nvandegiesen/Intervalometer/Sensor1.jpg

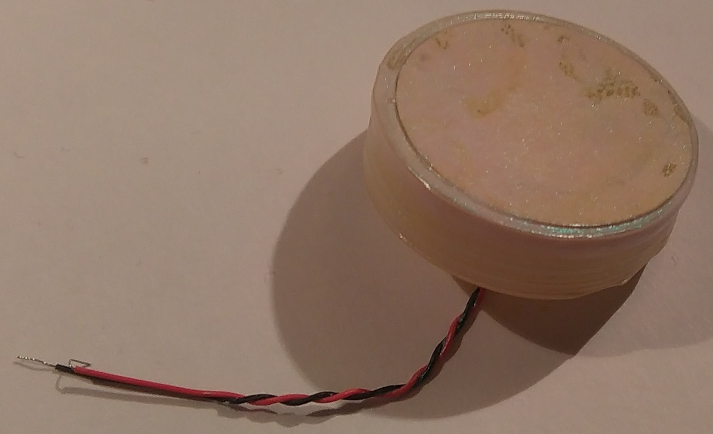
Sensor1.jpg
