nvandegiesen/Intervalometer/BACHELOR EINDPROJECT IRENE BACKERS.pdf

# Modelleren van Regenbuien in Afrika

# Modeling Rain Showers in Africa I.C.J. Backers

# Cover Text possibly spanning multiple lines ISBN 000-00-0000-000-0

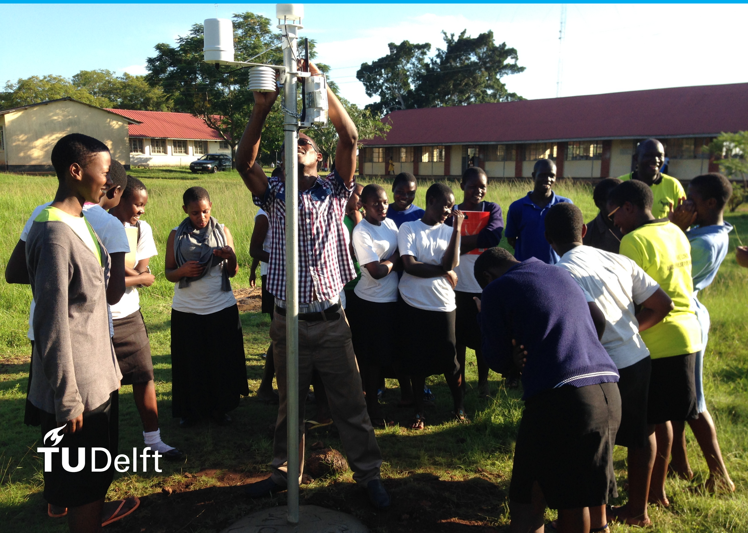
[picture p24: figure]

# Modelleren van Regenbuien in

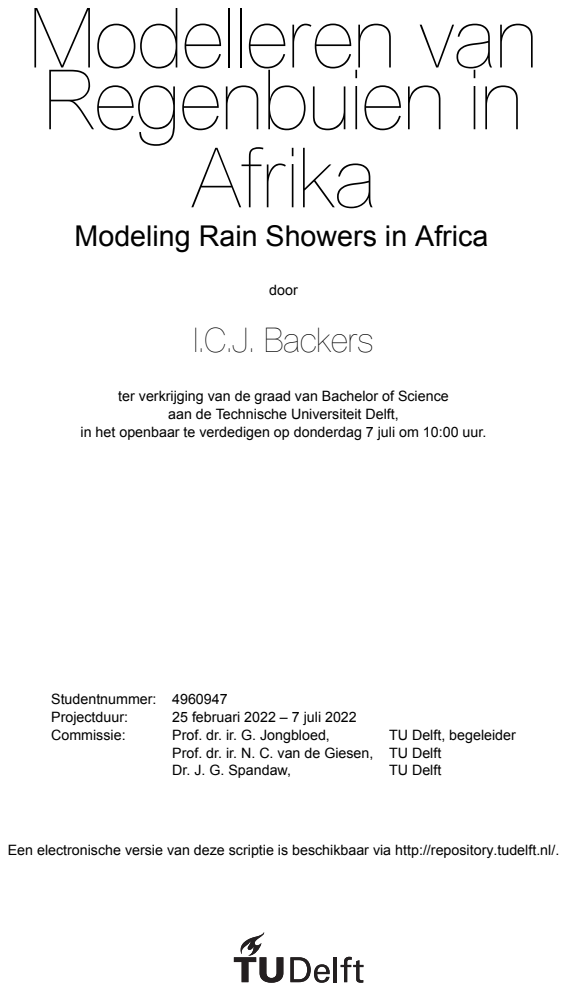
[picture p25: page 3]
Afrika; door I.C.J. Backers; Studentnummer: 4960947; Projectduur:; 25 februari 2022 – 7 juli 2022; Commissie:; Prof. dr. ir. G. Jongbloed,; TU Delft, begeleider; Dr. J. G. Spandaw,; TU Delft

Modeling Rain Showers in Africa

ter verkrijging van de graad van Bachelor of Science

aan de Technische Universiteit Delft,

in het openbaar te verdedigen op donderdag 7 juli om 10:00 uur.

Prof. dr. ir. N. C. van de Giesen, TU Delft

Een electronische versie van deze scriptie is beschikbaar via http://repository.tudelft.nl/.

# Voorwoord

Door klimaatveranderingen lijkt het weer steeds extremer te worden en moeilijker te voorspellen. Voor Afrika is erg weinig data beschikbaar om klimaatverandering te meten of in weermodellen te gebruiken. Vanuit de TU Delft is daarom al vanaf 2007 gewerkt aan de opzet van een netwerk van lowcost weerstations om gronddata te verzamelen.
Initator van dit project en voorzitter van Delft Global Initiative Prof. dr. ir. Nick van de Giesen klopte aan bij de afdeling statistiek van wiskunde met de vraag dat hij graag een metriek wilde hebben die de mate van Poissoniteit van de regen kwantificeert.

Door zelf opzoek te gaan naar een onderwerp voor mijn BEP ben ik met een paar mailtjes bij dit project terecht gekomen waar ik met veel plezier aan heb gewerkt. Wat voor mij het project zo leuk maakte, was dat ik kon werken met echte data. Alle rekenkunsten die ik de afgelopen vier jaar heb geleerd kon ik nu eindelijk echt een keer toepassen om een probleem waarvan het antwoord niet al van te voren vast staat. En wat het helemaal bijzonder maakt is dat het een heel klein deelprojectje is van een veel groter project om het klimaat van Afrika beter in kaart te brengen.
Graag wil ik Prof. dr. ir. Geurt Jongbloed heel erg bedanken voor de wekelijkse bijeenkomsten met nuttige gesprekken, suggesties, hulp en tijd. Ook Prof. dr. ir. Nick van de Giesen wil ik bedanken voor de hulp bij het formuleren van dit project, het beschikbaar stellen van de gebruikte data en voor het periodiek aanschuiven bij de bijeenkomsten. Als laatste wil ik ook Dr. Jeroen Spandaw bedanken voor het completeren van mijn beoordelingscommissie.

Irene Backers
Delft, Juni 2022

iii

# Samenvatting

Om goed te kunnen voorspellen waar, wanneer en hoeveel het gaat regenen is het belangrijk om satellietbeelden, weermodellen en grondmetingen te combineren. Het in 2007 opgezette project ‘The Trans-African Hydro-Meteorological Obsevatory’ (TAHMO) heeft de afgelopen jaren 500 goedkope weerstations geplaatst, verspreid over 21 landen in Sub-Sahara Afrika en wil uitbreiden naar 20.000 weerstations. De grondmetingen die met de al geplaatste weerstations zijn gedaan, kunnen gebruikt worden om weermodellen te ontwikkelen en te verbeteren.

Over de te verwachten regenval in Afrika is nog weinig bekend. Vaak wordt regen gemodelleerd met een Poissonproces. Daarom is vanuit ‘Delft Global Initiative’ de vraag gekomen of het Poissonproces een goed model kan zijn voor regenval in Afrika.

In dit onderzoek hebben we regendata van één weerstation gebruikt dat tijdens de moesson gegevens heeft verzameld op Mafia eiland, een eiland zo’n 20 kilometer voor de kust van Tanzania.

Een Poissonproces kan homogeen of inhomogeen zijn en we hebben de data op beide processen getoetst. Voor het homogene Poissonproces zijn veel verschillende toetsen te vinden in de literatuur. De Monte Carlo simulaties zijn gebaseerd is op de geïntegreerde verdelingsfunctie en gebruikt om de p-waarde te bepalen. Voor alle regen samen in de gehele observatieperiode was de p-waarde 0 en daarom kan de regen niet met een homogeen Poissonproces worden beschreven.
Voor de inhomogeen Poissonproces benadering hebben we ervoor gekozen om de intensiteit van de regen te benaderen met een stuksgewijs constante intensiteit. Met taut string werd de regen opgedeeld in 474 deelperiodes met een constante intensiteit die per deelperiode verschilt. Voor iedere deelperiode werd getoetst of de regen met een homogeen Poissonproces kan worden beschreven. De p-waarde werd voor iedere deelperiode bepaald met Monte Carlo simulaties en werken met een significantieniveau van 5%. Voor 448 van de 474 deelperiodes kan de regen met een homogeen Poissonproces worden beschreven.

Een inhomogeen Poissonproces met stuksgewijs constante intensiteit lijkt daarom een redelijk bruikbaar model om de regen op Mafia eiland mee te beschrijven. Of dit model ook bruikbaar is voor alle andere weerstations van TAHMO zullen toekomstige studies moeten uitwijzen.

v

# Lekensamenvatting

Om goed te kunnen voorspellen waar, wanneer en hoeveel het gaat regenen is het belangrijk om satellietbeelden, weermodellen en grondmetingen te combineren. Het in 2007 opgezette project ‘The Trans-African Hydro-Meteorological Obsevatory’ (TAHMO) heeft de afgelopen jaren 500 goedkope weerstations geplaatst, verspreid over 21 landen in Sub-Sahara Afrika en wil uitbreiden naar 20.000 weerstations. Over het voorspellen van regen in Afrika is nog nauwelijks wat bekend.

In dit onderzoek hebben we regendata van één weerstation gebruikt dat tijdens de moesson gegevens heeft verzameld op Mafia eiland, een eiland zo’n 20 kilometer voor de kust van Tanzania. Het Poissonproces is een gebruikelijk model om regen te modelleren. Uit de analyse van de data blijkt dat dit Poissonproces hier geen goed model is om de regen te beschrijven. Wanneer de regenmeting in kleinere deelperiodes wordt opgedeeld blijkt dat het Poissonproces de regen voor 448 van de 474 deelperiodes wel goed kan beschrijven en bruikbaar is om de regen op Mafia eiland mee te beschrijven. Of dit model, dat een inhomogeen Poissonproces wordt genoemd, ook bruikbaar is voor alle andere weerstations van TAHMO zullen toekomstige studies moeten uitwijzen.

vii

# Inhoudsopgave

Samenvatting | v
Lekensamenvatting | vii
1 Inleiding | 1
2 Het hoe, wat, waar en waarom van de dataverzameling | 3
3 Het Poissonproces | 9
4 Toetsen voor een homogeen Poissonproces | 15
5 Toetsen voor een inhomogeen Poissonproces | 35

5.2.3 Stap 3: Trek uit Poissonverdelingen met parameters uit de begin-intensiteit 40
5.2.4 Stap 4: Bepaal penalty parameter zodat afstand begin-intensiteit en ge-

ix

x | Inhoudsopgave
6 Conclusie en Discussie | 53

1

# Inleiding

Afrika’s economie is voor een groot deel afhankelijk van regen en toch weten we nog maar heel weinig over waar, wanneer en hoeveel het regent in Afrika. Met alle wetenschappelijke kennis van nu is dit onaanvaardbaar (TUDelft, 2019), zeker als je bedenkt dat de grootste sector in Afrika de agrarische sector is en dat de verbouwing van 98% van de gewassen afhankelijk is van regenwater (de Villiers e.a., 2021).

Om goed te kunnen voorspellen waar, wanneer en hoeveel het gaat regenen, moeten satellietbeelden, weer/klimaatmodellen en grondmetingen gecombineerd worden. Het ontbrak hierbij vooral aan de grondmetingen. Daarom is in 2007 ‘The Trans-African Hydro-Meteorological Observatory’ (TAHMO) opgezet. Het doel is om 20.000 goedkope weerstations te plaatsen verspreid over heel Sub-Sahara Afrika en zo het weer, het klimaat en de regen beter in beeld te kunnen brengen (TUDelft, 2019). De opstartfase duurde lang waardoor er pas in 2015 echt begonnen kon worden en er in juli 2019 500 weerstations verspreidt over 21 landen stonden.

Als we de regen beter kunnen voorspellen kan de voedselproductie verbeteren met alle voordelen van dien. Door de weerstations bij scholen te plaatsten en het op te nemen in het schoolprogramma, heeft het project ook educatieve waarde.

De data die met de grondmetingen verzameld is, kan gebruikt worden bij het verbeteren en ontwikkelen van weermodellen. Vaak wordt regen gemodelleerd met een Poissonproces en vanuit Delft Global Initiative (DelftGlobal, 2022) is de vraag gekomen of het Poissonproces een goed model kan zijn voor regenval in Afrika.

Uit een master thesis geschreven in 2019 en het daarop volgende artikel van de Villiers e.a., 2021 blijkt dat dit model voor de regen in Afrika niet goed past. In het artikel wordt het vermoeden geformuleerd dat regen met een lage intensiteit, bijvoorbeeld miezer, wel gemodelleerd kan worden met een Poissonproces, maar dat voor regen met hoge intensiteit, bijvoorbeeld een stortbui, het Poissonproces geen goed model lijkt te zijn.
In het artikel wordt met ‘Poisson’ verwezen naar een homogeen Poissonproces. De lichte regen lijkt dus wel een homogeen Poissonproces te zijn, maar de zwaardere regen niet. In het artikel wordt ook gewezen op het feit dat je een inhomogeen Poissonproces zou kunnen splitsen in kleinere stukken die homogeen Poisson zijn.

1

2 | 1. Inleiding

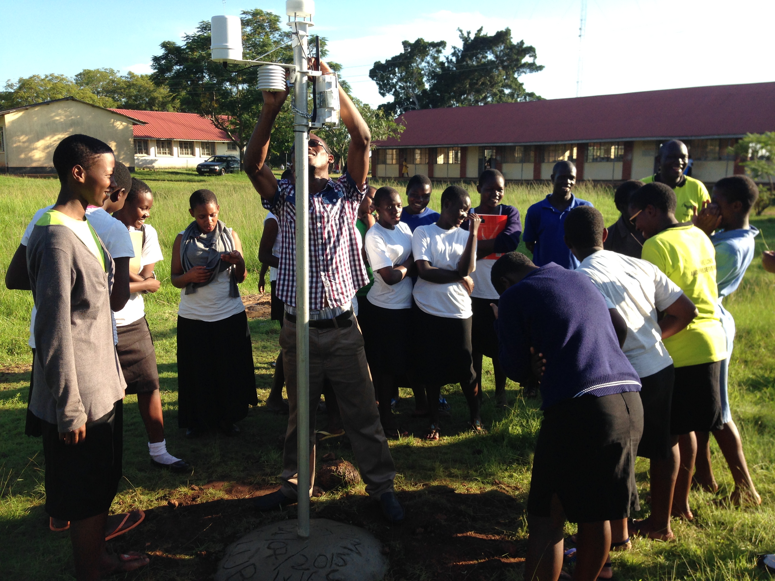
[picture p26: figure]

Figuur 1.1: Een weerstation bij een school in Afrika. Overgenomen van TUDelft, 2019

Het doel van dit project is om te onderzoeken of een Poissonproces, homogeen of inhomogeen, een redelijk model is om de regenbuien in Afrika mee te modelleren. Belangrijk om hierbij te onthouden is de wijsheid van de Britse statisticus George Box:

“All models are wrong, but some are useful”

Om het antwoord te vinden op deze vraag toetsen we eerst of de regen door een homogeen Poissonproces kan worden beschreven. Hiervoor gebruiken we een toets uit de literatuur. Daarna zullen we de regen toetsen op een inhomogeen Poissonproces door de data te benaderen met een stuksgewijs homogeen Poissonproces. We delen de regen op in allemaal kleine homogene Poissonprocessen die samen een inhomogeen Poissonproces vormen.

De structuur van het verslag is als volgt. Als eerste wordt in hoofdstuk 2 de data uitgelegd. Er wordt onder andere ingegaan op de gebruikte meetapparatuur, waar in Afrika de data voor dit project verzameld is, wanneer en waarom de data verzameld is en als laatste wordt uitgelegd hoe de beschikbare data eruit ziet. In hoofdstuk 3 wordt uitgelegd wat een Poissonproces is en hoe de data gebruikt kan worden om te toetsen op een homogeen of inhomogeen Poissonproces. Hoofdstuk 4 geeft een overzicht van (een deel van) de vele toetsen die er in de literatuur zijn voor een homogeen Poissonproces. Vervolgens wordt één van deze toetsen gekozen en uitgevoerd op de regendata. Tot slot wordt in hoofdstuk 5 de regendata getoetst op een inhomogeen Poissonproces. Hiervoor wordt eerst de intensiteit van de regen geschat met Taut String. Dit geeft een stuksgewijs constante intensiteit waardoor de regendata verdeeld wordt in periodes met dezelfde intensiteit. Deze periodes worden vervolgens getoetst op een homogeen Poissonproces.

2

# Het hoe, wat, waar en waarom van de dataverzameling

Dit hoofdstuk geeft een overzicht van de dataverzameling. Als eerste kijken we in paragraaf 2.1 naar de meetapparatuur waarmee de data verzameld is. In paragraaf 2.2 wordt uitgelegd waar en waneer de data verzameld is. Paragraaf 2.3 legt uit waarom de data verzameld is. Als laatste staat in paragraaf 2.4 welk deel van de beschikbare data gebruikt is voor dit project en wordt uitgelegd hoe de beschikbare data eruit ziet.

## 2.1. De meetapparatuur

De data is verzameld met drie verschillende meetinstrumenten: tipping bucket regenmeters gemaakt door Onset in de Verenigde Staten, akoestische disdrometers gemaakt door Disdro in Delft en intervalometers. In figuur 2.1 staat van alle drie een foto.
Tipping buckets meten de hoeveelheid regen, disdrometers registreren de aankomst van regendruppels en berekenen de grootte van de druppels en intervalometers registreren de aankomst van regendruppels (de Villiers, 2019). Voor dit onderzoek is gebruikt gemaakt van metingen gedaan met een intervalometer.

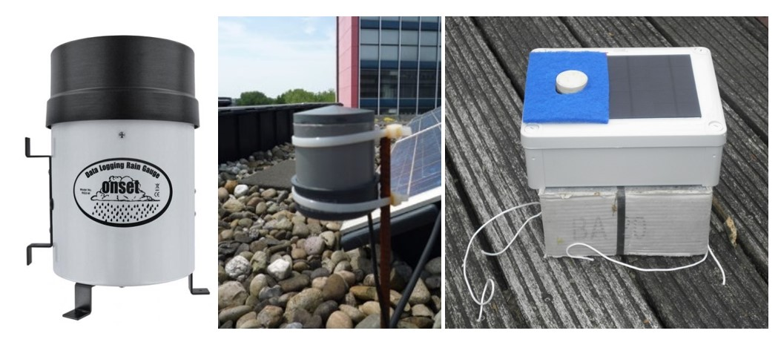
[picture p27: figure]

Figuur 2.1: De gebruikte meetinstrumenten. Van links naar rechts: een tipping bucket, een akoestische disdrometer en een intervalometer. Overgenomen van ONSET, 2022, Nieuwenhuizen, 2010 en van de Giesen, 2019.

3

4 | 2. Het hoe, wat, waar en waarom van de dataverzameling
| Intervalometers zijn meetinstrumenten die goedkoop zijn in aanschaf, gebruik en onder-
houd (TUDelft, 2022a). Ze kosten rond de 200 dollar, terwijl soortgelijke meetinstrumenten voor de Europese markt pas verkrijgbaar zijn vanaf 2000 dollar en meer (TUDelft, 2010). Het maken van dit goedkope meetinstrument kan door al bestaande apparatuur of onderdelen hiervan te gebruiken voor een ander doel dan waar het oorspronkelijk voor ontworpen was (TUDelft, 2010). Zo maakt een intervalometer gebruik van een piëzo-elektrische sensor van ongeveer 3,5 cm groot zoals in figuur 2.2. Als er een druppel op de sensor valt, dan vervormt de sensor en wordt er spanning opgewekt. Door de sensor aan een computer te verbinden, kan geregistreerd worden wanneer de druppels gevallen zijn en bijvoorbeeld ook hoe groot de druppels waren (van de Giesen, 2019).

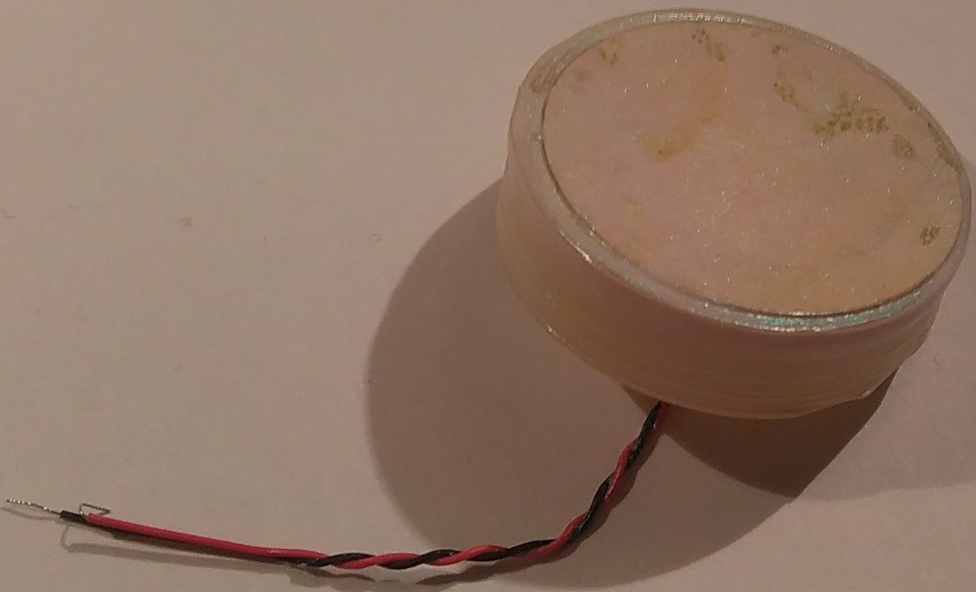
[picture p28: figure]

Figuur 2.2: De Piëzo-elektrische sensor die gebruikt wordt voor een intervalometer. De sensor is zo’n 3,5 cm groot en wekt spanning op als er een druppel op valt. Overgenomen van van de Giesen, 2019.

## 2.2. Waar en wanneer is de data verzameld?

De data is verzameld op acht locaties langs de zuidkust van Mafia Eiland, een eiland dat ongeveer 20 kilometer voor de kust van Tanzania. De locaties liggen in een gebied van 3,1 km bij 500 m en ongeveer in een lijn zoals de kaart in figuur 2.3 laat zien (de Villiers e.a., 2021). Op elke locatie staat in ieder geval één intervalometer. Pole Pole heeft naast een intervalometer ook nog een disdrometer en een tipping bucket; MIL 1 heeft twee intervalometers en een tipping bucket (de Villiers, 2019). De meetinstrumenten zijn zo geplaatst dat ze qua toegankelijkheid en landschap zo goed mogelijk voldoen aan de eisen van de Wereld Meteorologische Organisatie (de Villiers e.a., 2021), dit is een gespecialiseerde organisatie van de Verenigde Naties op het gebied van weer, klimaat en water (“Our Mandate”, 2022).

2.2. Waar en wanneer is de data verzameld? | 5

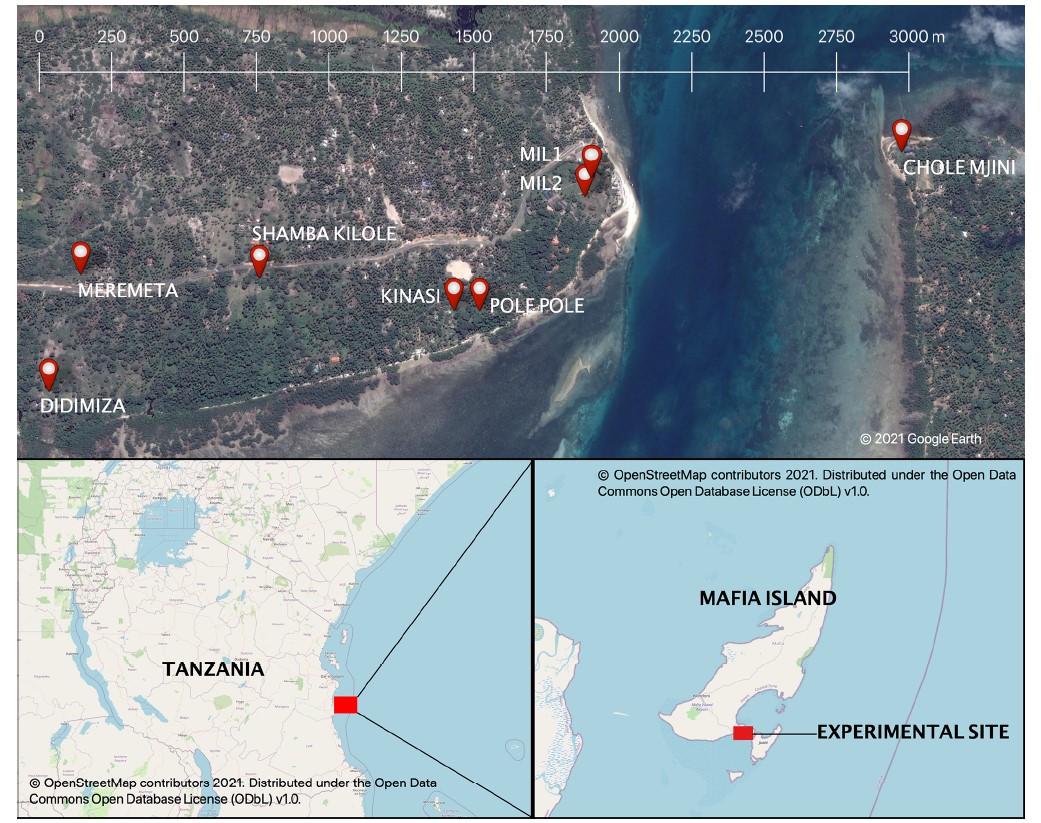
[picture p29: figure]

Figuur 2.3: De acht locaties waar de data verzameld is. Op alle locaties staat een intervalometer. Pole Pole heeft naast de intervalometer nog een disrometer en een tipping bucket. MIL 1 heeft nog een extra intervalometer (twee in totaal) en een tipping bucket. Overgenomen van de Villiers e.a., 2021.

De data is verzameld tijdens de moesson in Afrika. De eerste meting is gedaan op 27 april 2018 en de laatste op 18 juni 2018. Helaas is de dataverzameling niet altijd goed gegaan. Zo heeft de disdrometer vanaf 20 mei een oscillerend signaal gemeten waardoor de data niet meer te gebruiken is. Ook hebben een aantal intervalometers waterschade opgelopen tijdens zware buien waardoor ze tijdelijk geen data konden verzamelen. Twee intervalometers zijn dusdanig beschadigd dat ze niet meer te repareren waren.

Figuur 2.4 laat zien welke intervalometer wanneer data heeft verzameld. Elke intervalometer heeft de naam van de locatie behalve MIL 3, dit is de tweede intervalometer die bij MIL 1 staat.

Waarschijnlijk heeft het de ochtend van 9 mei hard geregend. Alle intervalometers die het op dat moment deden, zijn namelijk 9 mei uitgevallen, de eerste om 05:02 uur, de laatste om 09:13 uur. Op 12 mei waren de meeste intervalometers weer gerepareerd, alleen Chole Mjini en Shamba Kilole niet.

Na 12 mei zijn veel intervalometers nog één of meerdere keren uitgevallen. Daarom wordt er gewerkt aan een robuustere versie van de intervalometer

6 | 2. Het hoe, wat, waar en waarom van de dataverzameling

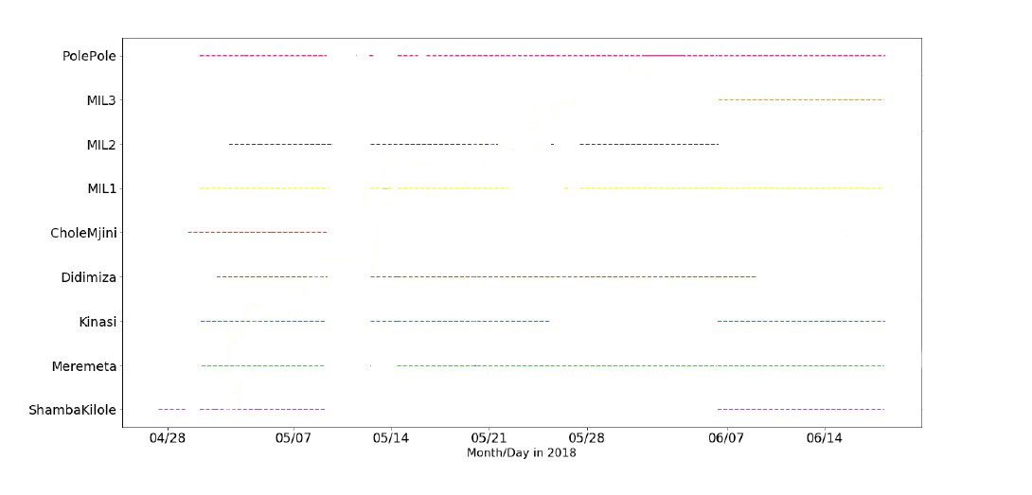
[picture p30: figure]

Figuur 2.4: Voor iedere locatie de periodes dat de intervalometers data hebben verzameld. Iedere intervalometer heeft de naam van de locatie behalve MIL 3, dit is de tweede intervalometer die bij MIL 1 staat. Aangepast overgenomen van de Villiers e.a., 2021.

## 2.3. Waarom wordt de data verzameld?

Momenteel weten we een stuk minder over het weer en klimaat in Afrika dan in bijvoorbeeld Europa (TUDelft, 2010). Dat we zo weinig weten van het weer en klimaat in Afrika komt onder andere door een gebrek aan data. Satellietbeelden waren er al wel maar data waargenomen vanaf de grond was er nauwelijks. In 2015 stond er volgens de Villiers e.a., 2021 minder dan één weerstation per 1 miljoen vierkante kilometer.
Ter vergelijking: in Nederland staan 48 automatische weerstations waarvan er 34 op land staan en 14 op zee (KNMI, 2022). Dit is één automatisch weerstation per 1.222 km²
. Naast
deze automatische weerstations staan er verspreid over heel Nederland ook nog ruim 300 neerslagmeters van vrijwilligers (KNMI, 2022).

Met de beschikbare satellietbeelden in Afrika kunnen wel wolken worden waargenomen, maar je weet dan nog niet of het regent, waar het regent en hoeveel het regent. Om dat te kunnen weten, heb je grondwaarnemingen nodig en zo ontstond het idee om ‘The Trans-African Hydro-Meteorological Observatory’ (TAHMO) op te zetten. Het doel is om 20.000 goedkope weerstations te plaatsten verspreid over Sub-Sahara Afrika (TUDelft, 2019). Deze grondwaarnemingen kunnen gebruikt worden om betere weer- en klimaatmodellen te ontwikkelen. Vervolgens kunnen de grondwaarnemingen, de modellen en de satellietbeelden gecombineerd worden om een goed beeld te krijgen van waar, wanneer en hoeveel het regent.

Het beter kunnen voorspellen van de regen heeft meerdere voordelen (TUDelft, 2022b). Op wetenschappelijk gebied krijgen we meer inzicht in het hydrologisch systeem. Deze kennis kan gebruikt worden op het gebied van waterkracht, irrigatie, drinkwater en overstromingen. Financieel gezien kunnen regeringen beter beslissen waarin geïnvesteerd gaat worden op het gebied van watermanagement. Door in de juiste dingen te investeren, kan er beter geanticipeerd worden op het weer waardoor oogsten kunnen verbeteren. De voedselproductie kan dus toenemen maar ook de oogstvoorspellingen worden beter. Ook kan de data gebruikt worden door verzekeraars, zo kunnen boeren bijvoorbeeld eerlijker gecompenseerd worden als er oogsten mislukken.

2.4. Welke data is er gebruikt en hoe ziet die data er uit? | 7

Als laatste zullen er ook educatieve voordelen zijn. De meetinstrumenten worden bij scholen geplaatst en worden opgenomen in het onderwijs. Zo kunnen de kinderen leren over het klimaat in Afrika en hun verbondenheid daarmee. Bij natuurkunde kunnen de meetinstrumenten worden gebruikt om experimenten te doen en het kan gebruikt worden om wiskunde toe te passen.

## 2.4. Welke data is er gebruikt en hoe ziet die data er uit?

Er is bijna 3 maanden aan regendata beschikbaar van acht verschillende locaties. Op aanraden van Didier heb ik er voor gekozen om data te gebruiken van een regenbui opgenomen op Pole Pole. Het gaat om regen die gevallen is vanaf 1 mei 12 uur tot 3 mei 10:30 uur. Deze periode noemen we de observatieperiode. In figuur 2.4 komt dit overeen met het eerste stukje van de roze stippellijn helemaal linksboven in de figuur.
De intervalometer heeft de tijdstippen opgenomen wanneer er een druppel op de drum valt. Van iedere druppel weten we tot op de milliseconde wanneer deze gevallen is. Ook hebben we een bestand met het aantal gevallen regendruppels per interval van 10 seconden. Een weergave hiervan staat in figuur 2.5. Op de x-as staat de tijd in uren waarbij we 1 mei 12 uur gelijk gesteld hebben aan tijdstip 0; op de y-as staat het aantal regendruppels per interval van 10 seconden. Het aantal druppels per interval heeft te maken met de intensiteit van de regen. Regent het zacht, dan zullen er weinig druppels per interval zijn. Regent het hard, dan zullen er veel druppels per interval zijn. De eerste 20 uur zijn er alleen maar intervallen met 0, 1, 2 of 3 druppels. Het heeft toen dus niet hard geregend. De drie uur daarna vielen er meer druppels per interval en heeft het dus harder geregend.

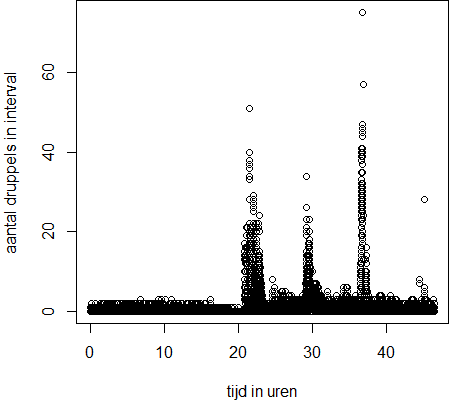
[picture p31: figure]

Figuur 2.5: Een weergave van het aantal druppels per interval gevallen bij Pole Pole van 1 mei 12 uur tot 3 mei 10:30. Op de x-as de tijd in uren met 1 mei 12 uur als tijdstip 0, op de y-as staat het aantal druppels per interval.

3

# Het Poissonproces

Dit hoofdstuk zal worden uitgelegd wat een Poissonproces is en hoe dit in de data terug kan komen. In paragraaf 3.1 worden definities en eigenschappen van een Poissonproces gegeven en uitgelegd. Vervolgens worden er drie manieren uitgelegd om naar een Poissonproces te kijken in paragraaf 3.2. Als laatste wordt in paragraaf 3.3 gekeken hoe de data zich moet gedragen als het een Poissonproces volgt en wordt er gekeken naar de mogelijkheden en onmogelijkheden van de data voor het toetsen op een homogeen en inhomogeen Poissonproces.

## 3.1. Wat is een Poissonproces?

Een Poissonproces is een speciaal soort telproces en telt of registreert het aantal ‘gebeurtenissen’ in een bepaald tijdsinterval (Pishro-Nik, 2014). Zo’n gebeurtenis wordt een aankomst genoemd. De aankomsten van een Poissonproces gebeuren met een bepaalde intensiteit maar wel volledig willekeurig zonder enige structuur en onafhankelijk van elkaar (Pishro-Nik, 2014). De intensiteit van het proces is het aantal aankomsten dat je verwacht in een tijdsinterval van lengte 1. Een Poissonproces wordt onder andere gebruikt voor het modelleren van de aankomst van mensen in een winkel, de uitstoot van radioactieve deeltjes door radioactief afval en het overgaan van de telefoon bij een klantenservice (Grimmett en Welsh, 2014).

Je kan het aantal aankomsten in een tijdsinterval registeren. Laat de tijd lopen van 0 tot oneindig, dus t ∈ [0, ∞), en laat Nt het aantal aankomsten tot en met tijdstip t zijn, dus in het interval [0, t]. Het proces N = (Nt

∶ t ∈ [0, ∞)) begint op tijdstip t = 0 met nul aankomsten N0 = 0, bij elke volgende aankomst neemt de waarde van het proces met 1 toe. Dit betekent dat het proces waardes aanneemt in {0,1,2,3,...} en dat N een discreet stochastisch proces is in continue tijd (Grimmett en Welsh, 2014). N = (Nt

∶ t ∈ [0, ∞)) is een telproces als het voldoet aan de volgende voorwaarden (Pishro-Nik, 2014, Grimmett en Welsh, 2014):

1. Nt

is een stochastische variabele die waardes aan neemt in {0, 1, 2, … },

2. N0 = 0, op tijdstip nul zijn er nul aankomsten,
3. Ns ≤ Nt als s ≤ t, het is dus een stijgend proces,
4. Voor 0 ≤ s < t is Nt − Ns het aantal aankomsten in het interval (s, t]. Dit aantal is onafhankelijk van het aantal aankomst voorafgaand aan s dus in het interval [0, s)

Een telproces heeft onafhankelijke aangroeiingen als voor 0 ≤ t1 < t2 < ⋯ < tn de stochastische variabelen Nt2−Nt1

, Nt3−Nt2

, …, Ntn−Ntn−1 onafhankelijk zijn van elkaar. Merk op

9

10 | 3. Het Poissonproces

dat Nti −Nti−1 het aantal aankomsten zijn in het tijdsinterval (ti−1, ti

]. Daarom heeft een telproces onafhankelijk aangroeiingen als de aantalen aankomsten in disjuncte (niet-overlappende) intervallen onafhankelijk zijn van elkaar (Pishro-Nik, 2014).

Een speciaal soort telproces is het Poissonproces. Er zijn meerdere manieren om een Poissonproces te definiëren waarvan één via de Poissonverdeling.
N = (Nt

∶ t ∈ [0, ∞)) is een Poissonproces met intensiteit λ als N voldoet aan de vier bovenstaande eisen van een telproces én als het aantal aankomsten tot en met tijdstip t een Poissonverdeling heeft met parameter λt. λ is het verwachte aantal aankomsten per interval van lengte 1. Dat betekent dat voor t > 0 de kans op j aankomsten in het tijdsinterval [0, t] gegeven is door (Grimmett en Welsh, 2014)

ℙ(Nt = j) =

(λt)je

−λt
j! | voor j = 0, 1, 2, … .

Uit deze definitie van een Poissonproces volgt dat de verwachting en de variantie van het aantal aankomsten tot en met tijdstip t, Nt

, gelijk is aan elkaar en lineair toeneemt als t toeneemt, namelijk:

E [Nt
] = λt, | var (Nt
) = λt | voor t > 0.

De intensiteit λ bepaalt of het Poissonproces homogeen of inhomogeen is. Als λ constant is in de tijd, dan is het Poissonproces homogeen. Als λ varieert in de tijd, dan is het Poissonproces inhomogeen.

Een homogeen Poissonproces heeft een aantal mooie eigenschappen waaronder het samenvoegen en splitsen van Poissonprocessen.
Neem aan dat N1 een Poissonproces is met intensiteit λ1 en dat N2 een Poissonproces is met intensiteit λ2 onafhankelijk van N1. Het samengevoegde proces N = N1 + N2 is dan een Poissonproces met intensiteit λ1 + λ2 (Grimmett en Welsh, 2014). Dit is gevisualiseerd in figuur 3.1.

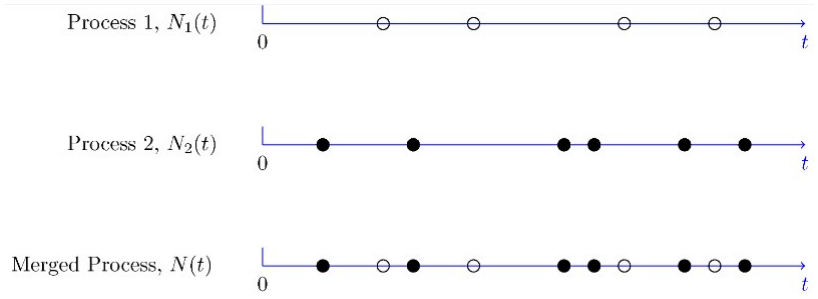
[picture p32: figure]

Figuur 3.1: Het samenvoegen van twee onafhankelijke Poissonprocessen. Overgenomen van Pishro-Nik, 2014.

Een Poissonproces kan ook gesplitst worden. Laat N een Poissonproces zijn met intensiteit λ, het proces kan op de volgende manier gesplitst worden in twee processen N1 en N2. Elke aankomst van het Poissonproces N gaat met kans p naar proces N1 en met kans 1 − p naar proces N2. N1 en N2 zijn dan onafhankelijk Poissonprocessen met intensiteit λp voor N1 en λ (1 − p) voor N2. Dit is gevisualiseerd in figuur 3.2.

3.2. Drie mogelijkheden om naar een Poissonproces te kijken | 11

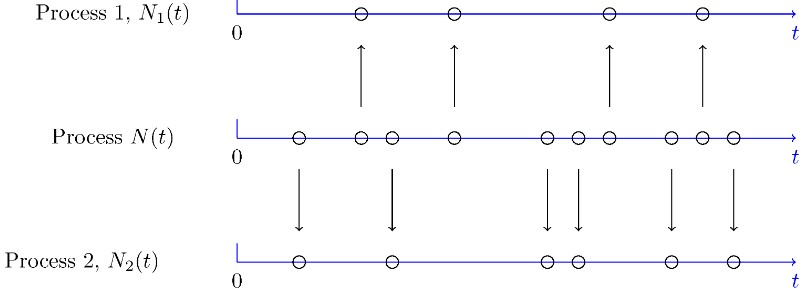
[picture p33: figure]

Figuur 3.2: Het splitsen van een Poissonproces in twee onafhankelijke Poissonprocessen. Overgenomen van Pishro-Nik, 2014.

Een andere eigenschap en ook definitie van een homogeen Poissonproces heeft te maken met de tussenaankomsttijden. De tussenaankomsttijd is de tijd tussen twee opeenvolgende aankomsten. Voor een homogeen Poissonproces met intensiteit λ zijn de tussenaankomsttijden onafhankelijke stochastische variabelen met de exponentiële verdeling met parameter λ.
Volgens Grimmett en Welsh, 2014 is dit niet alleen een eigenschap van een Poissonproces maar ook een manier om het Poissonproces te definiëren. Namelijk: als de tussenaankomsttijden van een proces onafhankelijk en exponentieel verdeeld zijn met parameter λ, dan is het een Poissonproces met intensiteit λ.

Een kenmerk van de exponentiële verdeling is de geheugenloosheid. Wat er in het verleden gebeurd is, heeft vanwege de geheugenloosheid geen invloed op wat op dit moment gaat gebeuren. Voor een Poissonproces betekent de geheugenloosheid dat de tijd van de eerdere aankomsten geen invloed heeft op de tijd van de volgende aankomst (Grimmett en Welsh, 2014).
Laat Ti de tussenaankomsttijd zijn van aankomsten i en i − 1, dus de tijd tussen aankomst i en aankomst i − 1. Gegeven dat we al tijd s wachten op de volgende aankomst, dan is de kans om nog tijd t extra te moeten wachten net zo groot als dat we vanaf het begin tijd t moeten wachten. Wiskundig is dit als volgt in kansen uit te drukken (Grimmett en Welsh, 2014):
ℙ(Ti > s + t | Ti > s) = ℙ(Ti > t)

Dat de tussenaankomsttijden onafhankelijk en exponentieel verdeeld zijn, geldt alleen voor een homogeen Poissonproces. Voor een inhomogeen Poissonproces zijn de tussenaankomsttijden niet meer onafhankelijk en ook niet meer exponentieel verdeeld (Yakovlev e.a., 2005).

## 3.2. Drie mogelijkheden om naar een Poissonproces te kijken

Met de Poissonverdeling van het aantal aankomsten en de exponentiële verdeling van de tussenaankomsttijden hebben we twee manieren om een homogeen Poissonproces te definiëren. Via deze definities kunnen we op verschillende manieren naar een Poissonproces kijken, waarvan er hier drie worden uitgelegd.

De eerste manier is via de Poissonverdeling. In de definitie zeiden we dat het aantal aankomsten tot en met tijdstip t Poisson-verdeeld moet zijn met parameter λt. Dit geldt niet

12 | 3. Het Poissonproces

alleen voor het aantal aankomsten in het interval [0, t] maar voor ieder interval van lengte t. Voor een Poissonproces met intensiteit λ moet het aantal aankomsten in een interval van lengte t dus Poisson-verdeeld zijn met parameter λt. Neem je een interval van lengte 1, dan is het aantal aankomsten in dat interval dus Poisson-verdeeld met parameter λ. Belangrijk hierbij is dat het aantal aankomsten in disjuncte intervallen onafhankelijk is van elkaar. Zo heeft het aantal aankomsten in het interval [0, t] bijvoorbeeld geen invloed op het aantal aankomsten in het interval [3t, 4t].
| Een tweede manier is via de exponentiële verdeling van de tussenaankomsttijden. Voor
een Poissonproces met intensiteit λ, zijn de tussenaankomsttijden onafhankelijk en exponentieel verdeeld met parameter λ.
| Een derde manier om naar een Poissonproces te kijken is via de tijd dat het duurt tot er een
bepaald aantal aankomsten is. Stel we willen weten hoe lang het duurt tot er n aankomsten zijn. Deze tijd is de tijd tot de eerste aankomst, plus de tijd tussen de eerste en tweede aankomst, plus de tijd tussen de tweede en derde aankomst, en zo door tot de tijd tussen de (n − 1)-ste en n-de aankomst. Dit is de som van de eerste n tussenaankomsttijden, het is dus een som van n onafhankelijke exponentieel(λ) verdeelde stochasten. Daarom is de tijd tot de n-de aankomst Gamma(n, λ) verdeeld (Kim, 2019).

## 3.3. Mogelijkheden en onmogelijkheden van de data

De data die beschikbaar is bestaat uit de tijdstippen waarop de druppels zijn gevallen en uit het aantal druppels per interval van 10 seconden. Zoals in paragraaf 2.4 beschreven, hebben we van al deze data maar een klein deel gebruikt. De gebruikte data is verzameld op Pole Pole van 1 mei 12:00 uur tot 3 mei 10:30 uur. Tijdens die periode zijn er 15.545 druppels gevallen, de tijdstippen waarop deze druppels gevallen zijn noemen we de aankomsttijden en geven we aan met X1, X2, … , Xn met n =15.545. X1 is dus de tijd waarop de eerste druppel
is gevallen en Xi | is de tijd waarop de i-de druppel is gevallen. Verdelen we de tijdsperiode
in intervallen van 10 seconden, dan krijgen we 16.734 tijdsintervallen. Het aantal druppels in die intervallen noemen we Y1, Y2, … , Ym met m =16.734. Y1 is dan het aantal druppels in het
interval [0, 10) en Yi | is het aantal druppels in het interval [10 (i − 1) , 10i). Deze data kunnen we gebruiken om te toetsen of de regen met een homogeen of inhomo-

geen Poissonproces kan worden beschreven. De mogelijkheden en onmogelijkheden van de data worden hieronder besproken.

### 3.3.1. Homogeen Poissonproces

Toetsen op een homogeen Poissonproces zou vrij makkelijk moeten kunnen. Als de regen namelijk een homogeen Poissonproces is kunnen we twee dingen doen:

| Als eerste kunnen we het aantal druppels per interval van 10 seconden Y1, … , Ym toetsen
op een Poissonverdeling. Neem in dit geval 10 seconden als eenheidslengte zodat ieder interval als het ware lengte 1 heeft. Als de regen een homogeen Poissonproces met intensiteit λ volgt, dan weten we van de definitie van een Poissonproces dat Y1, … , Ym onafhankelijk en Poisson-verdeeld moeten zijn met parameter λ. Verwerpen we dat Y1, … , Ym Poisson-verdeeld zijn met parameter λ, dan verwerpen we ook dat de regen met een homogeen Poissonproces met intensiteit λ kan worden beschreven. Verwerpen we niet dat Y1, … , Ym Poisson-verdeeld zijn met parameter λ, dan kan de regen met een homogeen Poissonproces beschreven worden.
| Een tweede mogelijkheid is om de tussenaankomsttijden te toetsen op een exponentiële
verdeling. Neem de aankomsttijden X1, … , Xn, de tussenaankomsttijden kunnen we bereke-

3.3. Mogelijkheden en onmogelijkheden van de data | 13

nen door het verschil te nemen van één aankomsttijd en de vorige aankomsttijd. Noem de tussenaankomsttijden T1, … , Tn. T1 is dan gelijk aan X1, T2 is de tijd tussen aankomst 1 en 2 en is dus gelijk aan X2 − X1, algemeen geldt dat Ti = Xi − Xi−1.
Als de regen met een homogeen Poissonproces met intensiteit λ kan worden beschreven, dan weten we van de definitie van een Poissonproces dat de tussenaankomsttijden T1, … , Tn onafhankelijk en exponentieel verdeeld moeten zijn met parameter λ. Verwerpen we dat T1, … , Tn exponentieel verdeeld zijn met parameter λ, dan verwerpen we ook dat de regen met een homogeen Poissonproces met intensiteit λ kan worden beschreven. Verwerpen we niet dat T1, … , Tn exponentieel verdeeld zijn met parameter λ, dan kan de regen met een homogeen Poissonproces worden beschreven.

### 3.3.2. Inhomogeen Poissonproces

Toetsen op een inhomogeen Poissonproces zal een stuk lastiger zijn. De intensiteit van het proces is niet constant maar varieert in de tijd. Neem je nu het aantal druppels per interval van 10 seconden, dan zal dit niet meer Poisson-verdeeld zijn met parameter λ. Wel kan de data in andere (kleinere) intervallen ingedeeld worden met elk een eigen constante intensiteit (de Villiers e.a., 2021).
Het lastige is nu dat je altijd een intensiteit kan vinden die bij een interval past als je de intervallen maar klein genoeg maakt [bron: gesprek Geurt 25 maart]. Voor een regenbui zou dit betekenen dat je er altijd een inhomogeen Poissonproces omheen kan bouwen door de intervallen klein genoeg te maken en voor ieder interval de intensiteit te schatten. Om na te gaan of deze schatting realistisch is, zou je het liefst meer data van dezelfde locatie willen hebben.

Zouden er meerdere intervalometers op dezelfde locatie staan, dan zou je de data van één intervalometer kunnen gebruiken om de intensiteit te schatten, en deze schatting vervolgens kunnen verifiëren met de data van de andere intervalometer(s). Als we nu aannemen dat de regen in de ruimte homogeen verdeeld is (niet perse Poisson), dan zou de intensiteit van dezelfde bui bij de verschillende intervalometers hetzelfde moeten zijn.
Behalve bij MIL 1 staat er op ieder locatie één intervalometer waardoor het met uitgekozen data van Pole Pole niet mogelijk is om op bovenstaande manier de intensiteit te schatten en te verifiëren. Wel heeft Pole Pole naast een intervalometer nog een tipping bucket en een disdrometer.
Deze meetinstrumenten hebben data verzameld van dezelfde buien op dezelfde locatie als de intervalometer. De data van deze verschillende meetinstrumenten zouden we kunnen gebruiken om de intensiteit te schatten en te verifiëren. Waar dan rekening mee gehouden moet worden, is dat het oppervlak waarop de druppels vallen anders is voor de verschillende meetinstrumenten. Op een groter oppervlak kunnen meer druppels vallen waardoor de intensiteiten niet één op één hetzelfde zullen zijn als je de intensiteit van dezelfde bui schat aan de hand van de data van de verschillende meetinstrumenten. De intensiteit van het ene meetinstrument zal waarschijnlijk een constante maal de intensiteit van het andere meetinstrument zijn.

Een andere mogelijkheid zou zijn om intervalometerdata te gebruiken van verschillende locaties die (redelijk) dicht bij elkaar liggen. Als we kunnen aannemen dat een regenbui in de ruimte homogeen verdeeld is over een bepaalde afstand, en als de intervalometers binnen deze afstand staan, dan zullen ze data verzamelen van dezelfde regen. Mogelijke locaties hiervoor zijn MIL 1 en 2 die 72 meter uit elkaar liggen en Pole Pole en Kinasi die 90 meter uit elkaar liggen.

14 | 3. Het Poissonproces

Nog een andere mogelijkheid is om te sampelen uit de intervalometerdata. Zo kun je als het ware simuleren dat je data hebt van meerdere intervalometers van dezelfde regenbui. Die data kan je gebruiken om de intensiteit te schatten en te verifiëren.

We zullen nu eerst in hoofdstuk 4 de data van Pole Pole toetsen op een homogeen Poissonproces. Daarna zullen we ook toetsen op een inhomogeen Poissonproces in 5. Hiervoor zullen we gebruikmaken van een methode om te sampelen uit de beschikbare data.

4

# Toetsen voor een homogeen Poissonproces

In dit hoofdstuk wordt getoetst of de regen van de data volgens een homogeen Poissonproces valt. Als eerste geven paragrafen 4.1 t/m 4.5 een uitgebreid overzicht van verschillende toetsen en toetsingsgrootheden uit de literatuur. De toetsen zijn ingedeeld in verschillende categorieën gebaseerd op Gürtler en Henze, 2000 en Karlis en Xekalaki, 2000. In deze paragrafen gaat het echt om het overzicht en is het doel niet om alle verschillende toetsen toe te passen. Daarna wordt in paragraaf 4.6 één van de toetsen gekozen. Als laatste wordt in paragraaf 4.7 deze toets toegepast op de regendata.

In Gürtler en Henze, 2000 gaan ze uit van X1, … , Xn onafhankelijke waarnemingen van de stochastische variabele X met onbekende verdelingsfunctie F. De verdelingsfunctie van een Poisson-verdeelde stochast met intensiteit λ is F(j; λ) ≔ e⁻λ ∑

j
l=0 λ
l/l!, j = 0, 1, 2 | De
hypothese die in dit artikel getoetst wordt, is

H0 ∶ X1, … , Xn zijn Poisson(λ) verdeeld, ofwel F = F(⋅; λ) voor een λ > 0

tegen een algemeen alternatief.

In Karlis en Xekalaki, 2000 wordt H0: de data komt van één Poissonverdeling, getoetst tegen H1: de data komt niet van een Poissonverdeling. ‘De data’ is hier niet gespecificeerd.

Zij Y1, … , Ym met m =16.734 het aantal druppels per interval van 10 seconden net als in paragraaf 3.3.
Als de regen op Pole Pole met een homogeen Poissonproces met intensiteit λ kan worden beschreven, dan weten we van de definitie van een Poissonproces dat Y1, … , Ym onafhankelijk en Poisson-verdeeld moeten zijn met parameter λ.
Wordt H0 verworpen dan zijn Y1, … , Yn geen onafhankelijke Poisson(λ)-verdeelde stochastische variabelen en kunnen we concluderen dat de regenval op Pole Pole niet met een homogeen Poissonproces met parameter λ kan worden beschreven.
Wordt H0 niet verworpen, dan hoeft dat niet te betekenen dat H0 waar is. H0 niet verwerpen is dus niet hetzelfde als concluderen dat de regen op Pole Pole met een homogeen Poissonproces kan worden beschreven.

Om H0 te kunnen toetsen hebben we een toetsingsgrootheid nodig. In de volgende paragrafen staat een uitgebreid overzicht van verschillende toetsingsgrootheden uit de literatuur.

15

16 | 4. Toetsen voor een homogeen Poissonproces

## 4.1. Toetsen gebaseerd op de empirische verdelingsfunctie

Laat de empirische verdelingsfunctie van X1, … , Xn gegeven zijn door Fn(j) ≔ n⁻¹ ∑

| n i=1 1{Xi≤j}

met 1{Xi≤j} de indicatorfunctie van de gebeurtenis {Xi ≤ j}

### 4.1.1. Kolmogorov-Smirnov toetsen

Gürtler en Henze, 2000 geven als toetsingsgrootheid

Kn ≔ sup
j≥0
| √n |Fn(j) − F(j; λ)| ̂

met λ̂een schatting voor de parameter λ.

### 4.1.2. Cramér-von Mises toetsen

Gürtler en Henze, 2000 geven als toetsingsgrootheid

Cn ≔ n

∞
∑

j=0

| [Fn(j) − F(j; λ)]̂
| 2 f(j, λ)̂

met f(j, λ)̂ de sprong van F(⋅, λ)̂
in j.
| Karlis en Xekalaki, 2000 geven vier verschillende Cramér-von Mises toetsingsgrootheden
namelijk

CVM1 = n⁻¹

| M
∑
| j=0 Z
| 2 j p (λ)̂ j

CVM2 = n⁻¹

M
∑

j=0

Z

2
j p

(λ)̂
j
Hj(1 − Hj)

CVM3 = n⁻¹

M
∑

j=0

Z

2
j

CVM4 = n⁻²

M
∑

j=0

Z

2
j Oj

met Zj = ∑

j

i=0 (Oi − E⁽λ)̂
i

), Oi het waargenomen aantal waarnemingen gelijk aan i, E

(λ)̂
i het

verwachte aantal waarnemingen gelijk aan i onder de nulhypothese, Hj = ∑

j
i=0 p

(λ)̂
i en p

(λ)̂
i
de kans op waarde i onder de nulhypothese. De bovengrens van de som, M, kan zo gekozen worden dat pM < 0.0001. CVM1, CVM2 en CVM3 zijn van Spinelli en Stephens, 1997 en CVM4 is van Henze, 1996.

### 4.1.3. Overig

Als laatste stellen Gürtler en Henze, 2000 Ln ≔ ∑

j≥0

√n |Fn(j) − F(j; λ)| ̂

voor als toetsingsgrootheid.

4.2. Toetsen gebaseerd op de geïntegreerde empirische verdelingsfunctie | 17

## 4.2. Toetsen gebaseerd op de geïntegreerde empirische verdelingsfunctie

De geïntegreerde verdelingsfunctie Ψ van de variabele X die Gürtler en Henze, 2000 gebruiken, is gedefinieerd als Ψ(t) ≔ E(X − t)⁺ = ∫

∞
t

(1 − F(x))dx. De geïntegreerde empirische verdelingsfunctie die Gürtler en Henze, 2000 gebruiken, is gegeven door Ψn(t) ≔
∫

∞
t

(1 − Fn(x))dx = n⁻¹ ∑

n
i=1(Xi − t)1{Xi>t}. Een voordeel van deze definitie is dat de functie begrensd is als E [X] bestaat.

Een schatter voor de geïntegreerde verdelingsfunctie onder Poissoniteit is dan Ψ̂
n(t) ≔ ∫

∞
t

(1 − F(x; λ))̂ dx. Gürtler en Henze, 2000 en Karlis en Xekalaki, 2000 geven een type Kolmogorov-Smirnov toetsingsgrootheid namelijk

In ≔ sup
t≥0

√n |Ψn(t) − Ψ̂
n(t)|

Beide artikelen verwijzen naar het artikel van Klar, 1999 waarin de toetsingsgrootheid ook voor discrete data wordt uitgewerkt:

In = max
0≤k≤M

√n| k−1
∑

j=0

(F(j, λ) − F ̂

n(j)) |

met M = max1≤i≤n Xi

## 4.3. Toetsen gebaseerd op de kansgenererende functie

De kansgenererende functie van X is g(u) ≔ E[uX] = ∑

∞
j=0 P(X = j)uj en kan geschat worden met de empirische kansgenererende functie gn(u) ≔ n⁻¹ ∑

n
i=1 u

Xi
. Als X Poisson(λ)
verdeeld is, dan is de kansgenererende functie g(u) = eλ(u−1)
Om H0 te toetsen kan gebruik worden gemaakt van het ‘empirische kansgenererende functie’-proces met geschatte parameter

Gn(u) ≔ √n(gn(u) − g(u; λ)) = ̂ √n (gn(u) − eλ(u−1) ̂

)

voor 0 ≤ u ≤ 1 en waar de tweede = volgt uit de kansgenererende functie van een Poissonproces met parameter λ. Toetsingsgrootheden voorgesteld door Gürtler en Henze, 2000 zijn:

- Rn ≔ ∫

1
0

G

2
n(u)du
- Rn,a ≔ ∫

1
0

G

2

n(u)uadu, een gewogen type Cramér-von Mises grootheid

- Tn ≔ n ∫

1
0

[Xngn(u) − g′

n(u)]²du, gebaseerd op de differentiaal vergelijking g

′
(u) =
λg(u)
Karlis en Xekalaki, 2000 hebben ook een toetsingsgrootheid gebaseerd op deze diffe-

rentiaalvergelijking Tn =

1
n

∑

n
i=1 ∑

n

j=1 (
X

2

Xi+Xj+1

+

XiXj

Xi+Xj−1 ) − (n − f0)X, met f0 het deel

van de waarnemingen gelijk aan nul

18 | 4. Toetsen voor een homogeen Poissonproces
- Tn,a ≔ n ∫

1
0

[Xngn(u) − g′

n(u)]²u

adu

- Vn ≔

1
n³ ∑

n
i,j,k,l=1 Xi(Xi − Xj − 1)Xk(Xk − Xl − 1)1{Xi+Xj=Xk+Xl }

, gebaseerd op de differentiaal vergelijking ∂

2/∂u²
[log (g(u; λ))] = 0
- V

∗
n ≔ Vn/(Xn)

1,45
Deze toetsingsgrootheid wordt ook door Karlis en Xekalaki, 2000 genoemd.

Toetsingsgrootheden voorgesteld door Karlis en Xekalaki, 2000, deels overeenkomende met de hierboven genoemde grootheden, zijn:

- K = | Gn(u)
exp{λ(û | 2−1)}−exp{2λ(u−1)}{1+ ̂ | λ(u−1) ̂ | 2}

. Een nadeel volgens Karlis en Xekalaki, 2000 is dat K afhangt van u.

- Een toetsingsgrootheid die niet van u afhangt is

dn(λ) =̂

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
Xi + Xj + 1 − 2 exp(−λ)̂

n
∑

i=1

T(Xi

, λ) + n ̂

1 − exp(−2λ)̂
2λ̂

,

met T(x, λ) =̂ ∫

1
| 0

u

x exp(λu) ̂ du. T(x, λ)̂ kan ook recursief berekend worden (zie p.364 van Karlis en Xekalaki, 2000).

- Tn in vorige opsomming al genoemd
- V

∗
n in vorige opsomming al genoemd

## 4.4. Toetsen gebaseerd op Fisher’s dispersie-index

Zoals in hoofdstuk 3 is uitgelegd, heeft een Poisson-verdeelde stochast gelijke verwachting en variantie. Delen we de variantie door de verwachting, dan zou daar 1 uit moeten komen. Dit is waar Fisher’s dispersie-index op gebaseerd is.
Fisher’s dispersie-index is door Gürtler en Henze, 2000 gedefinieerd als

Dn ≔

n
∑

i=1

(Xi − X)²

X

= (n − 1)

S

2

X

met X het gemiddelde en S

2 de variantie van de steekproef. H0 wordt verworpen voor grote of kleine waarden van Dn. In Karlis en Xekalaki, 2000 noemen ze dit de variantie toets en geven ze een geschaalde versie met toetsingsgrootheid

S

∗ =

X(Dn − n)²

∑

n
i=1 ((Xi − X)² − Xi)

Een andere toetsingsgrootheid die H0 verwerpt voor alleen grote waarden is

Û²

n2 ≔ (
1
√2n

(Dn − n))

2

4.4. Toetsen gebaseerd op Fisher’s dispersie-index | 19

De toetsingsgrootheid

Zj =

kj − X
√var (kj
|X)

, voor j = 2, 3, 4

gebruikt het feit dat de cumulanten van de Poissonverdeling optellen tot de Poissonparameter λ.
De cumulanten kj zijn de coefficenten van de Taylorreeks van de cumulant genererende functie rond de oorsprong. De cumulant genererende functie is de natuurlijke logaritme van de moment genererende functie (“Cumulants”, 2013):

KX(t) = ln MX(t) = ln E [etX] =

∞
∑

j=1

kj

t

j
j!

In de toetsingsgrootheid is kj de j-de cumulant en var (kj

|X) de variantie van de j-de cumulant gegeven de som van alle observaties. Uitwerkingen van Z2, Z3 en Z4 staan op p.359 van Karlis en Xekalaki, 2000.
Andere toetsingsgrootheden genoemd door Karlis en Xekalaki, 2000 zijn:
- Een algemene twee-parameter gamma-verdeling waarbij de eerste twee momenten van de dispersie-index overeenkomen met de momenten van de Gamma-verdeling.
- Om H0 ∶ σ² = μ te toetsen, heb je toetsingsgrootheid O2 = √(
n−1
2

) ( S

2
X

− 1) =

∑i

(Xi−X)²
X√2(n−1)

−

√n−1
√2

- Om een één-parameter Poissonverdeling te toetsen tegen een gemengde Poissonverdeling met dezelfde verwachting heb je Z = ∑i

(Xi−X)²
X√2n

− √
n
2

,

- Om de Poissonaanname te toetsen tegen een gegeneraliseerde Poissonverdeling met kansdichtheid P(X = x) = λ (λ + xθ)

x−1
exp {−λ + xθ} /x!, is er de toetsingsgrootheid W = ( S

2
X

− 1)²
n
2

- Sk = ∑

k
i=2 V

2
i

, met Vi de Poisson-Charlier polynomen van orde k. Zie p.361 van Karlis en Xekalaki, 2000 voor een definitie van Vi en een recurrente relatie die daaruit volgt. Voor k = 2 is de toetsingsgrootheid hetzelfde als Z die eerder in deze opsomming staat.

- Een toets die de coëfficiënten van scheefheid en kurtosis gebruiken met als toetsingsgrootheid T = 1
2

√
n

1+24X+6X

2

m2(m4−3m²
2

)−m3
X²

, met mk = n⁻¹ ∑

n
i=1(Xi − X)²
- Cox (1983) heeft de variantie toets veralgemeniseerd zodat hij geldig is voor alle exponentiële families zowel discreet als continu.
- Gelfand en Dalal (1990) hebben een toets voor overdispersie die lijkt op die van Cox. Ze hebben ook een grafische toets voor overdispersie gevonden.
- Voor andere manieren om grafisch de Poisson aanname te checken verwijzen Karlis en Xekalaki, 2000 naar Ord, 1967, Lindsay, 1986, Santner en Duffy, 1989, Hoagline, 1980 en Lindsay en Roeder, 1992.

20 | 4. Toetsen voor een homogeen Poissonproces
| • Pettigrew en Mohler hebben een toets gebaseerd op de range.
| • Lee heeft een toets gemaakt die gebaseerd is op een uitbreiding van de verdelingsklasse afhangend van een parameter. De Poissonverdeling heeft parameter 0.
| • De vorige toets van Lee leidt tot een variant van de variantie toets die een dispersie para- meter toevoegt aan de exponentiële familie. De toetsingsgrootheid voor de Poissonver-
| deling om te toetsen of de dispersie parameter 0 is, is EF = 2 ∑ n

i=1 {X−Xi+Xi
ln (

Xi
X

) } =

2 ∑

n
i=1 Xi

ln (

Xi
X

)

## 4.5. Overige toetsen

Karlis en Xekalaki, 2000 geven nog vijf verschillende goodness-of-fit toetsen die niet in één van de vorige vier categorieën passen. De eerste is de Χ

2
-toets met toetsingsgrootheid

Χ

2 =

k
∑

i=0

(Oi − E⁽λ)̂
i

)

2

E

(λ)̂
i

met Oi de waargenomen aantallen van i en E

(λ)̂
i de verwachte aantallen van i onder de nulhypothese. Een voordeel van de toetsingsgrootheid is dat deze makkelijk te berekenen is.

De tweede toets is de (multinomial) likelihood ratio test (LRT) met een toetsingsgrootheid die ook asymptotisch Χ

2 verdeeld is. Een groot nadeel is dat de benodigde berekeningen onbetaalbaar zijn.

Een derde toets is ontworpen door Nass in 1959 met toetsingsgrootheid

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
(λ)̂
i

− n − (m − 1)
√[
m−1
m

{2m − (m+1)²+2m
n

+ ∑

m
i=0

1

E

(λ)̂
i

}]

met n de grootte van de steekproef en m het grootst waargenomen aantal.

Een vierde goodness-of-fit toets is een groep toetsen die de power divergent toetsingsgrootheid van Read en Cressie (1988) gebruikt

I

λ =

1
λ (λ + 1)

m
∑

i=0

E

(λ)̂
i

{(
Oi

E

(λ)̂
i

)

λ+1
− 1}, λ ∈ ℝ

Bijzondere gevallen van de power divergent toetsingsgrootheid zijn:

1. λ = 1 is de Χ

2
-toetsingsgrootheid
2. λ = 0 is de multinomial likelihood ratio toetstingsgrootheid als de limiet voor λ naar 0 wordt genomen.
3. λ = −2 is de Neyman Χ

2
-toets

4.6. Toets kiezen | 21
4. λ = 1
2

is de Freeman-Tukey toets

volgens Read en Cressie is λ = 2
3

een erg goed compromis.

De vijfde en laatste goodness-of-fit toets is de minimum disparity goodness-of-fit toets van Basu en Sarkar (1994). Deze toets is gerelateerd aan de vorige toetsen.

Een andere toets die niet in één van de vorige vier categorieën passen is de Likelihood ratio toets. De likelihood ratio toets kan volgens Karlis en Xekalaki, 2000 goed gebruikt worden als de nulhypothese een speciaal geval is van de alternatieve hypothese. In hun artikel gebruiken ze deze toets om een Poissonverdeling te toetsen tegen een gemengde Poissonverdeling met twee parameters. De toetsingsgrootheid is

L = 2(L1 − L0)

met Li

, i = 0, 1 de gemaximaliseerde log-likelihoods van de hypotheses Hi

## 4.6. Toets kiezen

Om te bepalen of de regen met een homogeen Poissonproces kan worden beschreven, is het belangrijk om de juiste toets te kiezen. Bij het kiezen van de juiste toets maakt het uit hoe je naar een Poissonproces kijkt (zie hoofdstuk 3) en wat je wil toetsen. Wil je weten of het aantal druppels per tijdsinterval Poisson-verdeeld is, wil je weten of de tussenaankomsttijden exponentieel verdeeld zijn of wil je weten of de som van de tussenaankomsttijdens gamma verdeeld is?
De toetsen hierboven zijn allemaal gericht op het toetsen van een Poissonverdeling van het aantal druppels per tijdsinterval. Sommige van deze toetsen zijn ook te gebruiken om te toetsen op een exponentiële verdeling van de tussenaankomsttijden. Dit zijn onder andere de Chi-kwadraat toets en de Kolmogorov-Smirnov toets (Winton, 2009).

In Karlis en Xekalaki, 2000 en Gürtler en Henze, 2000 worden in de conclusie de ‘beste’ toetsingsgrootheden genoemd. Welke toetsingsgrootheden het beste zijn, wordt bepaald aan de hand van het onderscheidend vermogen van de toetsingsgrootheid bij verschillende alternatieven, hoe makkelijk de waarde van de toetsingsgrootheid te berekenen is en soms ook in hoeverre de verdeling van de toetsingsgrootheid onder de nulhypothese bekend is. Het onderscheidend vermogen van de toetsingsgrootheden wordt in beide artikelen bepaald met simulaties.
Kijken we naar de conclusies van beide artikelen, dan worden de volgende toetsingsgrootheden genoemd als goede toetsingsgrootheden, ingedeeld in de categorieën die eerder dit hoofdstuk ook gebruikt zijn. Voor details met betrekking tot de afwegingen van de auteurs verwijzen we naar de artikelen Gürtler en Henze, 2000 en Karlis en Xekalaki, 2000.
1. Toetsen gebaseerd op de empirische verdelingsfunctie:
- Cramér-von Mises toetsingsgrootheden* krijgen volgens Karlis en Xekalaki, 2000 de voorkeur boven Kolmogorov-Smirnov toetsingsgrootheden. Karlis en Xekalaki, 2000 verwijzen voor de verschillende Cramér-von Mises toetsingsgrootheden naar Spinelli en Stephens, 1997 en volgens hun gaat de voorkeur uit naar CVM2.
- Ln ≔ ∑j≥0 √n |Fn(j) − F(j; λ)| ̂ | , krijgt volgens Gürtler en Henze, 2000 de voorkeur
boven andere toetsen gebaseerd op de empirische verdelingsfunctie.
2. Toetsen gebaseerd op de geïntegreerde empirische verdelingsfunctie:

22 | 4. Toetsen voor een homogeen Poissonproces
- In ≔ supt≥0 √n |Ψn(t) − Ψ̂
| n(t)|, is een type Kolmogorov-Smirnov toetsingsgroot- heid en krijgt de voorkeur boven Ln.
3. Toetsen gebaseerd op de kansgenererende functie:
- Tn,5 ≔ n ∫

1
0

[Xngn(u) − g′

n(u)]

2
u
| 5du, krijgt volgens Gürtler en Henze, 2000 de
voorkeur boven Ln.
- Rn,5 ≔ ∫

1
0

G

2

n(u)u⁵du, een gewogen type Cramér-von Mises grootheid. Rn,5 krijgt volgens Gürtler en Henze, 2000 de voorkeur boven Ln.

- V

∗

n ≔ Vn/ (Xn)

1,45
, is volgens Gürtler en Henze, 2000 goed als het alternatief een uniforme verdeling is.
4. Toetsen gebaseerd op Fisher’s dispersie-index:
- Alle toetsingsgrootheden gebaseerd op de variantie-gemiddelde ratio doen het goed bij alternatieve verdelingen met een variantie groter dan de verwachting (overdispersie) en bij alternatieven verdelingen met een variantie kleiner dan dan verwachting (onderdispersie). Bij alternatieve verdelingen met een variantie gelijk aan de verwachting (equidispersie) doen deze toetsingsgrootheden het niet goed.
- Z4 =

m4−3S²−X
√2nX(nX−1)(49+ ¹⁰⁸(nX−2)
n−2 +

12(n+1)(nX−2)(nX−3)

n(n−2)(n−3) )

n√n − 1, met mk = n⁻¹ ∑

n
i=1 (Xi − X)

2
,

lijkt het goed te doen bij een kleine steekproef en equidispersie.
- O2 = √(
n−1
2

) ( S

2
X

− 1) =

∑i

(Xi−X)²
X√2(n−1)

−

√n−1
√2

, is goed voor zowel over- als onderdispersie
- T = 1
2

√
n

1+24X+6X

2

m2(m4−3m²
2

)−m3
X²

lijkt het net als Z4 goed te doen bij een kleine

steekproef en equidispersie.

Ik kies er voor om de toetsingsgrootheid In te gebruiken. Volgens Gürtler en Henze, 2000 en Karlis en Xekalaki, 2000 krijgt In de voorkeur boven Ln en Ln krijgt dan weer de voorkeur boven Cramér-von Mises toetsingsgrootheden. Daarom krijgt In de voorkeur boven zowel Ln als Cramér-von Mises toetsingsgrootheden. In krijgt de voorkeur omdat voor de meeste alternatieven gebruikt in Gürtler en Henze, 2000, het onderscheidend vermogen van In groter is dan het onderscheidend vermogen van Ln en Cramér-von Mises toetsingsgrootheden. Het gaat dan om binomiale, negatief binomiale, gemengde en gegeneraliseerde Poisson-, zeta-, logaritmische en twee uniforme verdelingen. Tegen de andere drie gebruikte uniforme verdelingen was het onderscheidend vermogen van In lager dan het onderscheidend vermogen van Ln en Cramér-von Mises toetsingsgrootheden.
Een andere reden om voor In te kiezen is dat de toetsingsgrootheid volgens Gürtler en Henze, 2000 makkelijk en extreem snel te implementeren is. Dit is handig als je zelf simulaties wilt uitvoeren.
Een derde reden om voor In te kiezen is dat het een type Kolmogorov-Smirnov toetsingsgrootheid is en daarom ook gebruikt kan worden om te toetsen op een exponentiële verdeling van de tussenaankomsstijden Winton, 2009. Echter gelden bovenstaande argumenten over het onderscheidend vermogen van In tegen verschillende alternatieven dan niet meer. Het onderscheidend vermogen is namelijk bepaald met een Poissonverdeling in de nulhypothese en niet een exponentiële verdeling.

4.7. Toets uitvoeren | 23

Een reden om te willen kunnen toetsen op een Poissonverdeling van het aantal regendruppels per tijdsinterval en op een exponentiële verdeling van de tussenaankomsttijden van de druppels is de volgende: het kan zo zijn dat je wel verwerpt als je een dataverzameling toetst op een Poissonverdeling van het aantal regendruppels per interval maar dat je niet verwerpt als je dezelfde dataverzameling toetst op een exponentiële verdeling van de tussenaankomsttijden.

## 4.7. Toets uitvoeren

Zowel Gürtler en Henze, 2000 als Karlis en Xekalaki, 2000 beschrijven in hun artikel kort de toetsingsgrootheid In en verwijzen allebei naar het artikel van Klar, 1999. De dataset in dit artikel bestaat uit onafhankelijke gelijk verdeelde stochastische variabelen X1, X2, … , Xn met verdelingsfunctie F. Zij F een familie discrete verdelingen, de nulhypothese die getoetst wordt is H0 ∶ F ∈ F tegen H1 ∶ F ∉ F.

We willen toetsen op een Poissonverdeling van het aantal druppels per interval. Daarom gebruiken we als data Y1, … , Ym met Yi het aantal druppels gevallen in het interval [10(i − 1), 10i). F bestaat uit de verdelingsfuncties van de Poissonverdeling, F = {F(j; λ) ≔ e⁻λ ∑

j
l=0 λ
| l/l!,
voor, λ > 0 en j = 0, 1, 2 … }. λ is hier de parameter en omdat we te maken hebben met een Poissonverdeling is λ gelijk aan het verwachte aantal druppels per interval van 10 seconden.

De nulhypothese wordt H0 ∶ F ∈ F tegen H1 ∶ F ∉ F. In woorden is dit H0 ∶ het aantal regendruppels per tijdsinterval volgt één Poissonverdeling met niet nader gespecificeerde waarde van λ, tegen H1 ∶ het aantal regendruppels per tijdsinterval volgt geen Poissonverdeling.

### 4.7.1. De toetsingsgrootheid

De toetsingsgrootheid In is gebaseerd op het verschil tussen de geïntegreerde verdelingsfunctie van Y, Ψ(t) ≔ E(Y − t)⁺ = ∫

∞
t

(1 − F(y))dy en de empirische geïntegreerde verdelingsfunctie Ψm(t).

In ≔ sup
t≥0

√m|Ψm(t) − Ψ(t)| ̂

Met

Ψm(t) = ∫

∞

t

(1 − Fm(y))dy =

1
m

m
∑

i=1

(Yi − t)1{Yi>t}

Ψ(t) = ̂ | ∫ ∞
| t

(1 − F (y, λ))̂ dy

Hierin is Fm(y) de empirische verdelingsfunctie van Y1, … , Ym en λ̂een schatter voor de parameter λ. 1{Yi>t} is de indicatorfunctie van de gebeurtenis {Yi > t}, de functie is dus 1 als Yi groter is dan t en 0 als Yi kleiner dan of gelijk is aan t. De toetsingsgrootheid kan als volgt worden omgeschreven:

24 | 4. Toetsen voor een homogeen Poissonproces

In = sup
k≥0

√m |Ψm(t) − Ψ(t)| ̂

= sup
k≥0

√m |∫

∞

k

(1 − Fm(y))dy − ∫

∞

k

(1 − F (y; λ))̂ dy|

= sup
k≥0

√m |∫

∞

k

(F (y; λ) − F ̂ m(y))|

= sup
k≥0

√m |
∞
∑

j=k

(F (j; λ) − F ̂ m(j))|

= max
0≤k≤M

√m |
∞
∑

j=k

(F (j; λ) − F ̂ m(j))|

= max
0≤k≤M

√m |
k−1
∑

j=0

(F (j; λ) − F ̂ m(j))|

met M = max1≤i≤m Yi
. De laatste gelijkheid krijgen we door vergelijkingen 4.1 en 4.2 van elkaar af te halen:

∞
∑

j=0

(1 − Fm(j)) = Y ⟹

k−1
∑

j=0

(1 − Fm(j)) = Y −

∞
∑

j=k

(1 − Fm(j)) | (4.1)

∞
∑

j=0

(1 − F (j; λ)) = ̂ Y ⟹

k−1
∑

j=0

(1 − F (j; λ)) | = ̂ | Y −

∞
∑

j=k

(1 − F (j; λ))̂ | (4.2)
(4.1) − (4.2) ⟹

k−1
∑

j=0

(F (j; λ) − F ̂ m(j)) =

∞
∑

j=k

(Fm(j) − F (j; λ))̂ | (4.3)

In vergelijking 4.3 zijn F en Fm weliswaar omgedraaid ten opzichte van de toetsingsgrootheid maar omdat je de absolute waarde neemt, maakt de volgorde niet uit. |F − Fm| is namelijk gelijk aan |Fm − F|.
F (j, λ)̂

is de verdelingsfunctie van een Poissonverdeling met λ̂een schatter voor λ, daarom geldt F (j, λ) = e ̂ −λ̂∑

j
l=0 λ̂

l/l!. Klar, 1999 schrijft in zijn artikel dat λ̂ een geschikte schatter moet zijn voor λ maar schrijft niks over welke schatters wel en niet geschikt zijn. Veel gebruikte schatters zijn de momentschatter (method of momements) en de maximum-likelihoodschatter. Om te bepalen welke schatter we in dit geval het beste kunnen gebruiken, rekenen we eerst beide schatters uit. Daarna vergelijken we de schatters aan de hand van het gemiddelde van de kwadratische afwijkingen (mean square error), deze wil je zo klein mogelijk hebben.

### 4.7.2. Schatter voor lambda

Bijma e.a., 2017 leggen in hun boek uit hoe je de momentschatter kan vinden. Zij X1, … , Xn een steekproef van een verdeling met onbekende parameter θ. De momentschatter voor θ is de

4.7. Toets uitvoeren | 25

waarde θ̂waar het j-de moment overeenkomt met het j-de steekproefmoment: Eθ̂(Xj
| ) = Xj .
Als X1, … , Xn gelijk verdeelde onafhankelijke stochastische variabelen van een steekproef zijn, dan is het j-de steekproefmoment Xj = n⁻¹ ∑
| n i=1 X j i . Bij het berekenen van de momentschatter

gaat de voorkeur uit naar de kleinste mogelijke j. Voor 1-dimensionale parameters is j = 1 vaak al genoeg.
Onder de aanname dat de regendata Y1, … , Ym Poisson-verdeeld zijn met parameter λ kunnen we de momentschatter λ̂als volgt vinden. We nemen j = 1 waardoor we Eλ̂(Y) = Y moeten oplossen. Omdat voor een Poisson-verdeelde stochast de verwachting gelijk is aan de parameter wordt deze vergelijking λ =̂ Y. De schatter voor λ is dus gelijk aan het gemiddelde van de steekproef.

In Bijma e.a., 2017 wordt ook uitgelegd hoe je de maximum-likelihood-schatter kan vinden. Zij X een stochastische vector met kansdichtheid pθ die afhankelijk is van een parameter θ ∈ Θ. Voor vaste x is de functie θ ↦ L (θ; x) ≔ pθ(x) de likelihood functie.
De maximum-likelihood-schatter voor θ is de waarde van T(x) ∈ Θ waarvoor de likelihood functie maximaal is.
Een andere manier om de maximum-likelihood-schatter te vinden is door de log-likelihood functie θ ↦ log L (θ; x) = log pθ(x) te maximaliseren. Als de kansdichtheid pθ een product is van (marginale) dichtheden kan de log-likelihood de berekeningen een stuk eenvoudiger maken.

Laat (y1, … , ym) waarnemingen zijn van de regendata Y = (Y1, … , Ym) en neem aan dat Y1, … , Ym onafhankelijk en Poisson-verdeeld zijn met parameter λ. De kansdichtheid is dan pλ(yi) = e

−λλ

yi

yi

!

. De maximum-likelihood-schatter voor λ kunnen we als volgt vinden. De likelihood functie is θ ↦ L (λ; y1, … , ym) = ∏

| m i=1 pλ(yi) omdat dit een product is van marginale

dichtheden werken we met de loglikelihood.

λ ↦ log (L (λ; y1, … , ym)) = log

m
∏

i=1

pλ(yi)

= log

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
[log (e⁻λ) + log (λ

yi) − log (yi
!)]

=

m
∑

i=1

[−λ + yi
log λ − log (yi

!)]

= −mλ + log λ

m
∑

i=1

yi −

m
∑

i=1

log (yi

!)

De log-likelihood willen we nu maximaliseren. Dit doen we door de afgeleide naar λ gelijk

26 | 4. Toetsen voor een homogeen Poissonproces

te stellen aan nul.

d
dλ
| log (L (λ; y1, … , ym)) = 0

d
dλ

[−mλ + log λ
m
∑

i=1

| yi − m
∑
| i=1 log (yi !)] = 0

−m +

1
λ

m
∑

i=1

yi = 0

λ =̂

1
m

m
∑

i=1

yi

λ =̂ Y

De log-likelihood heeft dus een extreme waarde voor λ = Y. Om te bepalen of dit een minimum of een maximum is berekenen we de tweede afgeleide:

d

2
dλ

2

log (L (λ; y1, … , ym)) =

d
dλ

[−m +
1
λ

m
∑

i=1

yi

| ] = −
1
λ

2

m
∑

i=1

yi

De tweede afgeleide is altijd kleiner dan 0 dus de log-likelihood heeft een maximum voor λ = Y en daarom is de maximum-likelihood-schatter voor λ gelijk aan Y.

Zowel de momentenschatter als de maximum-likelihood-schatter voor λ zijn Y, het gemiddelde van de steekproef. Beide zullen dus dezelfde gemiddelde kwadratische afwijking hebben, namelijk:

MSE(λ; Y) = Eλ ||Y − λ||²

= varλ (Y) + (EλY − λ)

2

= varλ (
1
m

m
∑

i=1

yi) + (Eλ [
1
m

m
∑
i=1 | yi

] − λ)

2

=

1
m²

m
∑

i=1

varλ

(yi

) + (
1
m

m
∑

i=1

Eλ

[yi

] − λ)

2

=

1
m²

⋅ m ⋅ varλ

(y1

) + (
1
m

⋅ m ⋅ Eλ

[xm] − λ)

2

=

1
m

⋅ λ + (λ − λ)

2

=

1
m

⋅ λ

### 4.7.3. Verwerpen van de nulhypothese

We toetsen de nulhypothese H0 ∶ het aantal regendruppels per tijdsinterval volgt een Poissonverdeling met constante intensiteit, tegen het alternatief H1 ∶ het aantal regendruppels per

4.7. Toets uitvoeren | 27

tijdsinterval volgt geen Poissonverdeling met constante intensiteit.
We verwerpen H0 voor grote waarden van de toetsingsgrootheid. Wat groot is, hangt van de situatie af en moeten we dus bepalen. Met behulp van Monte Carlo simulaties kunnen we de kritieke waardes en de p-waardes bepalen waarvoor we H0 verwerpen.
Als de waarde van de toetsingsgrootheid groter is dan de kritieke waarde, dan verwerp je dat de data van een Poissonverdeling met parameter λ komt. Voor welke p-waarde de nulhypothese wordt verworpen, hangt af van het significantieniveau. Hier nemen we een significantieniveau van 5% en wordt de nulhypothese verworpen voor een p-waarde kleiner dan 0,05. Een significantieniveau van 5% betekent dat naar verwachting in 5% van de gevallen de nulhypothese onterecht wordt verworpen (Bijma e.a., 2017).

We toetsen een dataset op een Poissonverdeling. Om de kritieke waardes en p-waardes voor deze dataset te bepalen met een Monte Carlo simulatie, bepaal je als eerste het aantal runs van je simulatie. Dit getal mag je zelf kiezen maar hoe meer runs, hoe dichter bij de echte kritieke waarde en dus hoe kleiner de fout. Daarna trek je per run net zoveel punten uit een Poissonverdeling als de dataset punten heeft. Stel het aantal runs is 500 en de dataset heeft 100 punten, dan trek je 500 keer 100 punten uit een Poissonverdeling met parameter λ. De waarde van de parameter van de Poissonverdeling kan je zelf kiezen of bepalen aan de hand van de data. We beginnen met een simulatie waarbij de waardes van de parameter zelf zijn gekozen, daarna voeren we ook nog een simulatie uit waarbij de waardes van de parameter geschat zijn aan de hand van de data. Dit laatste heet een parametrische bootstrap.

### 4.7.4. Simulatie met zelfgekozen parameters

In tabel 4.1 staan voor vijf verschillende gekozen waardes van λ de kritieke waardes van tien simulaties van elk 1000 runs en 2500 trekkingen uit een Poissonverdeling met parameter λ = 0, 1; 0, 2; 0, 5; 1; 2.
Te zien is dat met 1000 runs de kritieke waardes voor λ = 0, 1; 0, 2; 0, 5; 1 in het tweede decimaal verschillen en voor λ = 2 zelf in het eerste decimaal. Het is daarom beter om meer runs uit te voeren zodat de kritieke waarde uit de simulatie dichter bij de echte kritieke waarde zit.

Tabel 4.1: Kritieke waardes van 10 simulaties van elk 1000 runs en 2500 trekkingen uit een Poissonverdeling voor verschillende waardes van de parameter λ met een significantie niveau van 5%.

λ → | 0,1 | 0,2 | 0,5 | 1 | 2
Kritieke waardes | 0.125 0.245 0.443 0.663 0.933
0.128 0.225 0.467 0.682 | 0.911
0.131 0.229 0.444 0.668 0.931 0.127 0.232 0.496 0.657 0.914 0.126 0.254 0.457 0.646 0.934 0.122 0.224 0.446 0.669 0.934 0.125 0.232 0.440 0.665 0.878 0.127 0.250 0.464 0.654 0.908 0.124 0.247 0.451 0.653 0.931 0.131 0.223 0.477 0.655 0.957

Bij 10.000 runs was er voor λ = 0, 5; 1; 2 in 12 van de 30 simulaties een verschil in het tweede decimaal, voor λ = 0, 1; 0, 2 waren bij alle 10 de simulaties de eerste twee decimalen hetzelfde.

28 | 4. Toetsen voor een homogeen Poissonproces
| Bij 100.000 runs was er voor λ = 0, 5; 1; 2 in 3 van de 30 simulaties een verschil in het
tweede decimaal, voor λ = 0, 1; 0, 2 waren bij alle 10 de simulaties de eerste twee decimalen hetzelfde. Omdat de computer bij 100.000 runs er soms al 25 à 30 seconden over doet om de kritieke waardes uit te rekenen en er maar in 3 van de 50 simulaties een verschil is in het tweede decimaal, kiezen we er voor om verder te werken met 100.000 runs per simulatie.

### 4.7.5. Simulatie met geschatte parameters

Nu het aantal runs per simulatie is gekozen, gaan we simulaties aan de hand van de data uitvoeren. De nulhypothese stelt dat de data een homogene Poissonverdeling met intensiteit λ > 0 volgt. De waarde van λ is nog niet bekend en kan alles zijn zolang het maar groter dan 0 is. De nulhypothese is dus samengesteld en daarom gaan we een parametrische bootstrap uitvoeren. Bij een parametrische bootstrap gebruik je in plaats van een zelfgekozen parameter een parameter die geschat wordt aan de hand van de oorspronkelijke data (Pennsylvania State University, 2018). Voordat we simulaties gaan uitvoeren, kijken we eerst wat beter naar de data die we hebben.
Figuur 4.1 is een plot van de Y1, … , Ym, het aantal druppels in de intervallen 1, … , m. Op de x-as staat de index van het interval en op de y-as staat het aantal druppels in dat interval, bij bijvoorbeeld x-waarde interval-index 1 hoort als y-waarde het aantal druppels in het interval [0, 10).

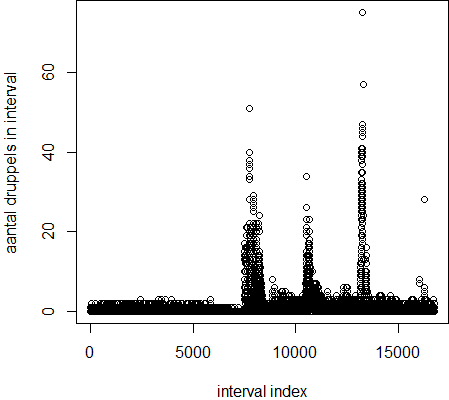
[picture p34: figure]

Figuur 4.1: Het aantal druppels per interval Y1

, … , Ym. Op de x-as staat de index van het interval, op de y-as het aantal druppels in het interval.

Kijken we naar het aantal druppels per interval in figuur 4.1 dan lijkt de intensiteit niet constant gedurende de tijd. Er zitten drie hoge pieken in het aantal druppels en ook drie wat lagere pieken.
Dit blijkt ook als we een parametrische bootstrapsimulatie uitvoeren. Daar komt een p-

4.7. Toets uitvoeren | 29

waarde uit van 0. Dat betekent dat we voor ieder significantieniveau verwerpen dat het aantal druppels per interval homogeen Poisson-verdeeld is.

In het artikel van de Villiers e.a., 2021 wordt geconstateerd dat vooral regen met een lage intensiteit een Poissonverdeling lijkt te volgen en regen met een hoge intensiteit niet. Het zou daarom kunnen dat er deelperiodes zijn waarvoor het aantal druppels per interval wel homogeen Poisson-verdeeld kan zijn.
Om dit te onderzoeken delen we de data Y1, … , Ym, op het oog, op in deelperiodes zodat in die deelperiodes de intensiteit redelijk constant is. We kunnen bijvoorbeeld Y1, … , Y7500 zien als één deelperiode. De observatieperiode is opgedeeld in vijftien deelperiodes. Iedere deelperiode is in figuur 4.2 aangegeven met een eigen kleur.

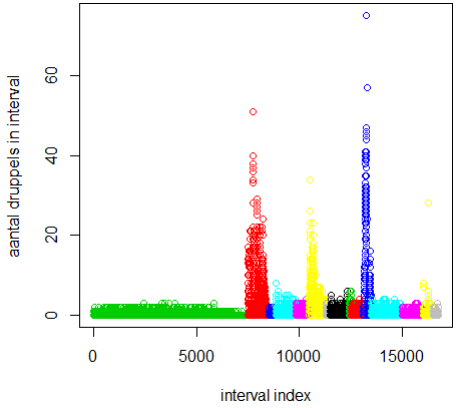
[picture p35: figure]

Figuur 4.2: De vijftien deelperiodes waarin de data op het oog is verdeeld.

Voor iedere deelperiode voeren we een parameterische bootstrapsimulatie uit.
Als eerste schatten we de intensiteit van de deelperiodes met het steekproefgemiddelde. Iedere simulatie bestaat uit 100.000 runs, in iedere run trekken we net zoveel punten uit een Poissonverdeling met parameter gelijk aan het steekproefgemiddelde als de deelperiode intervallen heeft. Voor iedere trekking berekenen we de waarde van de toetsingsgrootheid en zo kunnen we de kritieke waarde en de p-waarde berekenen.
De kritieke waarde met significantie niveau 5% is het 0,95-kwantiel, H0 wordt verworpen als de waarde van de toetsingsgrootheid van de dataset groter is dan het 0,95-kwantiel van de gerealiseerde bootstrapwaarde.
De p-waarde wordt berekend door de fractie te nemen van de waardes van de toetsingsgrootheid van de trekking die groter zijn dan de waarde van de toetsingsgrootheid van de deelperiode.
We berekenen de p-waarde omdat die meer informatie geeft over de significantie dan de

30 | 4. Toetsen voor een homogeen Poissonproces

kritieke waarde [bron]. Is de p-waarde bijvoorbeeld 0 dan zou H0 bij ieder significantieniveau verworpen worden, maar is de p-waarde bijvoorbeeld 0,03 dan wordt H0 wel verworpen bij een significantieniveau van 5% maar niet bij een significantieniveau 1%. Dit zou je niet kunnen concluderen als alleen de kritieke waarde bekend is.

De resultaten van de parametrische bootstrapsimulaties staan in tabel 4.2. Voor iedere deelperiode bevat de tabel de geschatte parameter λ̂ onder de aanname dat de data een Poissonverdeling volgt, de kritieke waarde, de p-waarde, de waarde van de toetsingsgrootheid van de deelperiode en of de nulhypothese, dat het aantal regendruppels per tijdsinterval een Poissonverdeling volgt, wel of niet wordt verworpen. H0 wordt verworpen als de waarde van de toetsingsgrootheid groter is dan de kritieke waarde en/of als de p-waarde kleiner is dan het significantieniveau van 0,05.

Tabel 4.2: Voor verschillende datasets de waarde van λ̂
, de kritieke waarde, de p-waarde, de waarde van de toetsingsgrootheid en of H0 wordt verworpen. De kritieke waardes en p-waardes zijn berekend met een parametrische bootstrap, een Monte Carlo simulatie van 100.000 runs waarbij wordt getrokken uit een Poissonverdeling met parameter gelijk aan λ̂

. λ̂
is het steekproefgemiddelde van het aantal druppels per interval voor de intervallen in een deelperiode. We verwerpen H0 als de waarde van de toetsingsgrootheid groter is dan de kritieke waarde of als de p-waarde kleiner is dan het significantieniveau van 0,05.
interval-index | λ̂ | kritieke waarde | p-waarde | toetsingsgrootheid | verwerpen ja/nee
0:7500 | 0.1825 | 0.2159 | 0.0698 | 0.2000 | nee
7500:8500 | 4.0819 | 1.3072 | 0 | 43.592 | ja
8500:8850 | 0.2963 | 0.3207 | 0.1904 | 0.2139 | nee
8850:9850 | 0.7702 | 0.5816 | 0 | 1.3073 | ja
9850:10.450 | 0.6639 | 0.5373 | 0.5991 | 0.1868 | nee
10.450:11.300 | 3.1974 | 1.1572 | 0 | 21.1696 | ja
11.300:11.500 | 0.6318 | 0.5190 | 0.0182 | 0.6245 | ja
11.500:12.400 | 0.6604 | 0.5364 | 0.1714 | 0.3829 | nee
12.400:12.500 | 1.8020 | 0.8703 | 0.7821 | 0.2638 | nee
12.500:13.100 | 0.5790 | 0.4978 | 0.1459 | 0.3743 | nee
13.100:13.500 | 8.4239 | 1.8806 | 0 | 77.9782 | ja
13.500:15.000 | 0.5929 | 0.5028 | 0.8167 | 0.1061 | nee
15.000:16.000 | 0.2657 | 0.2955 | 0.8127 | 0.0503 | nee
16.000:16.500 | 0.4731 | 0.4436 | 0 | 2.1884 | ja
16.500:16.734 | 0.3191 | 0.3398 | 0.1513 | 0.2473 | nee

Opvallend is wat er gebeurt bij het aantal druppels Y11.500, … , Y12.500. In figuur 4.3 staan van links naar rechts plots van het aantal druppels Y11.500, … , Y12.400 (4.3a), Y12.400, … , Y12.500
(4.3b) en Y11.500, … , Y12.500 (4.3c).

Als je in tabel 4.2 de p-waardes van de deelperiodes Y11.500, … , Y12.400 en Y12.400, … , Y12.500 apart bekijkt, dan zijn de p-waardes respectievelijk 0,17 en 0,78 en wordt voor beide deelperiodes apart de nulhypothese niet verworpen. Bekijk je echter de p-waarde van beide deelperiodes samen (Y11.500, … , Y12.500) dan is de p-waarde 0,0003 en wordt de hypothese wel verworpen. In de drie plotjes in figuur 4.3 is te zien dat het verwerpen van de nulhypothese niet te wijten is aan een hoge piek in de intensiteit. Het zelfde gebeurt bij Y13.500, … , Y15.000 en Y15.000, … , Y16.000. Dit zou kunnen duiden op een inhomogeen Poissonproces.

4.7. Toets uitvoeren | 31

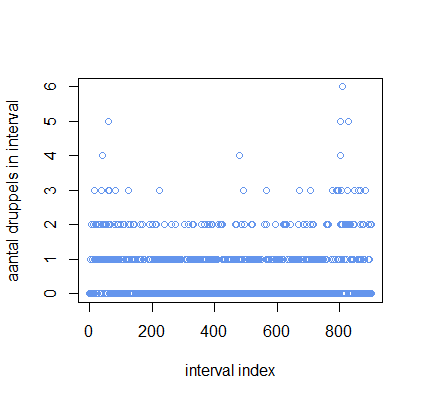
[picture p36: figure]
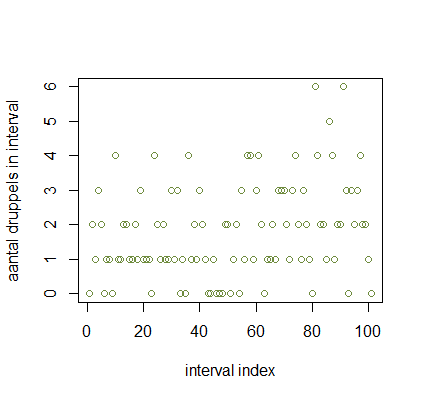
[picture p37: figure]
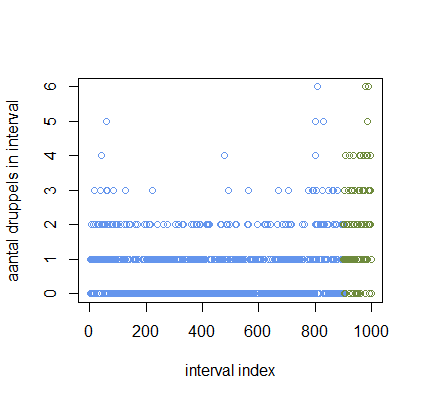
[picture p38: figure]

(a) Y11.500, … , Y12.400 | (b) Y12.400, … , Y12.500 | (c) Y11.500, … , Y12.500

Figuur 4.3: Het aantal druppels per interval voor verschillende deelperiodes. De linker plot is de deelperiode met aantal druppels Y11.500, … , Y12.400, de middelste plot is de deelperiode met aantal druppels Y12.400, … , Y12.500. Voor deze deelperiodes wordt de nulhypothese niet verworpen. De rechter plot is het aantal druppels van beide deelperiodes samen (Y11.500, … , Y12.500), hiervoor wordt de nulhypothese wel verworpen.

Wat erg belangrijk is om te beseffen, is dat we aan data snooping of p-hacking doen door de regendata op deze manier te onderzoeken. We kiezen bewust bepaalde deelperiodes uit om toetsen op uit te voeren om zo een significant resultaat te krijgen (Lechner e.a., 2021). Dit kan tot gevolg hebben dat we een patroon in de data vinden dat statistisch significant is terwijl er eigenlijk geen patroon is. We moeten dus voorzichtig zijn met het trekken van conclusies gebaseerd op de resultaten in tabel 4.2.

Ook goed om te beseffen, is dat we met schattingen en simulaties te maken hebben. Eerst schatten we de waarde van λ van de deelperiode en daarna voeren we met die geschatte waarde simulaties uit. We zullen dus nooit de exacte kritieke waarde en de exacte p-waarde krijgen. Als je met een grensgeval te maken hebt, kan het zo zijn dat je bij de ene simulatie een p-waarde krijgt van 0,049 en bij de volgende simulatie voor dezelfde dataset een p-waarde van 0,051. Bij een significantie-niveau van 5% zou je bij de eerste simulatie wel verwerpen en bij de tweede niet terwijl het dezelfde dataset is.

Wat we daarom doen, is een interval bepalen waarin de p-waarde zich bevindt. Hiervoor berekenen we voor iedere deelperiode eerste het 95%-betrouwbaarheidsinterval voor de schatting van λ. Met de boven- en ondergrens van die betrouwbaarheidsintervallen voeren we simulaties uit en zo krijgen we voor iedere deelperiode een interval voor de p-waarde. De resultaten hiervan staan in tabel 4.3. Dit zijn dezelfde deelperiodes als in tabel 4.2. In de derde kolom staan de intervallen voor de p-waardes. Te zien is dat er geen deelperiodes zijn die zich bij een significantieniveau van 5% op de grens bevinden van wel of niet verwerpen, maar er zijn wel intervallen met een flink verschil tussen de boven en ondergrens. Zo is bij de deelperiode met interval-indices 8500:8850 het verschil tussen de boven- en ondergrens 0,1316. Dat is dus een verschil van 13%. Bij de laatste deelperiode met interval-indices 16.500:16.734 is dit verschil zelfs ruim 14%.

Ondanks dat de intervallen van de p-waardes bij deze indeling van deelperiodes geen verschil zouden maken tussen wel of niet verwerpen van de nulhypothese, kan er dus wel een groot verschil zijn tussen de boven- en ondergrens van de p-waardes wat misschien bij een andere indeling in deelperiodes zou kunnen leiden tot een andere conclusie of er wel of niet verworpen wordt.

32 | 4. Toetsen voor een homogeen Poissonproces

Tabel 4.3: Voor verschillende deelperiodes het 95%-betrouwbaarheidsinterval voor λ̂ en een interval voor de p-waarde. De p-waardes zijn berekend met een parametrische bootstrap, een Monte Carlo simulatie van 100.000 runs waarbij wordt getrokken uit een Poissonverdeling met parameter gelijk aan de boven- en ondergrens van het betrouwbaarheidsinterval van λ̂
interval-index | 95%-betrouwbaarheidsinterval voor λ̂ | interval voor p-waarde
0:7500 | [0.1729, 0.1922] | [0.0586, 0.0839]
7500:8500 | [3.9568, 4.2071] | [0, 0]
8500:8850 | [0.2393, 0.3532] | [0.1223, 0.2539]
8850:9850 | [0.7159, 0.8246] | [0, 0]
9850:10.450 | [0.5988, 0.7290] | [0.5576, 0.6390]
10.450:11.300 | [3.0773, 3.3176] | [0, 0]
11.300:11.500 | [0.5219, 0.7417] | [0.0088, 0.0288]
11.500:12.400 | [0.6073, 0.7134] | [0.1495, 0.1952]
12.400:12.500 | [1.5402, 2.0638] | [0.7306, 0.8198]
12.500:13.100 | [0.5182, 0.6399] | [0.1198, 0.1753]
13.100:13.500 | [8.1399, 8.7080] | [0, 0]
13.500:15.000 | [0.5540, 0.6319] | [0.7968, 0.8358]
15.000:16.000 | [0.2338, 0.2977] | [0.7693, 0.8452]
16.000:16.500 | [0.4128, 0.5333] | [0, 0]
16.500:16.734 | [0.2469, 0.3914] | [0.0792, 0.2215]

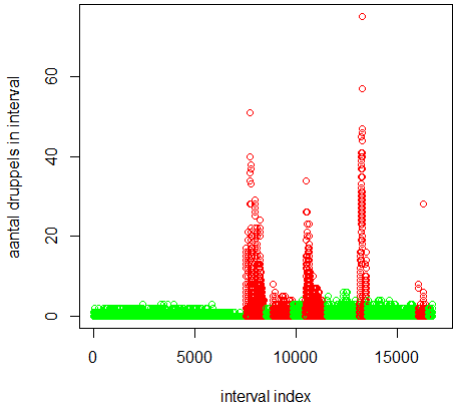
[picture p39: figure]

Figuur 4.4: Het aantal druppels per interval. Op de x-as staat de index van het interval, op de y-as het aantal druppels in het interval. Voor de groene punten wordt de nulhypothese, de data is homogeen Poisson-verdeeld, niet verworpen; voor de rode punten wel.

Om een beter beeld te krijgen voor welke deelperiodes de nulhypothese wel en niet verworpen wordt, staat in figuur 4.4 een plot van het aantal druppels per interval waarbij de intervallen

4.7. Toets uitvoeren | 33

groen en rood gekleurd zijn. Voor het aantal druppels in de groene intervallen wordt de nulhypothese niet verworpen op basis van de simulatie in tabel 4.2, voor het aantal druppels in de rode intervallen wel. Uit de figuur komt duidelijk naar voren dat regen met lage intensiteit homogeen Poisson kan zijn en dat de hoge pieken niet homogeen Poisson zijn.

### 4.7.6. Conclusie wel of niet homogeen Poisson

Uit bovenstaande simulaties kunnen we concluderen dat alle regendata over de observatieperiode niet met een homogeen Poissonproces kan worden beschreven, de nulhypothese wordt hiervoor verworpen. Wel zijn er deelperiodes van de observatieperiode waarvoor de nulhypothese niet wordt verworpen en waarvoor het regenvalproces dus wel met een homogeen Poissonproces kan worden beschreven. Er zijn ook twee deelperiodes naast elkaar waarvoor de nulhypothese niet wordt verworpen als je de periodes apart bekijkt, maar waarvoor de nulhypothese wel wordt verworpen als je de periodes samen bekijkt. Dit zou er op kunnen wijzen dat de regendata met een inhomogeen Poissonproces kan worden beschreven, al moeten we vanwege data snooping voorzichtig zijn met het trekken van conclusies. In het volgende hoofdstuk wordt op een objectieve manier de data in deelperiodes verdeeld met Taut String en wordt onderzocht of de regen met een inhomogeen Poissonproces kan worden beschreven.

In paragraaf 4.6 staat uitgelegd dat het nuttig zou kunnen zijn om zowel te toetsen op een Poissonverdeling van het aantal druppels per interval als op een exponentiële verdeling van de tussenaankomsttijden. Dat was ook een reden om voor de toetsingsgrootheid In te kiezen. In paragraaf 4.7 hebben we veel aandacht besteed aan het toetsen op een Poissonverdeling van het aantal druppels per interval maar helaas hebben we geen tijd meer gehad om ook te toetsen op een exponentiële verdeling van de tussenaankomsttijden.

5

# Toetsen voor een inhomogeen Poissonproces

In het vorige hoofdstuk hebben we aan de hand van Monte Carlo simulaties kunnen concluderen dat de regen in de gehele observatieperiode niet met een homogeen Poissonproces kan worden beschreven. Wel zijn er deelperiodes waarop de regendata wel door een homogeen Poissonproces kan worden beschreven, de nulhypothese wordt hier niet verworpen. Dit zou er op kunnen wijzen dat de regendata inhomogeen Poisson-verdeeld is. Het indelen van de regendata in verschillende deelperiodes hebben we echter op het oog gedaan. Vanwege datasnooping moeten we dan ook voorzichtig moeten zijn met het trekken van conclusies op basis van deze indeling.

Dit hoofdstuk gaan we de indeling van de regendata in verschillende deelperiodes objectiever doen met behulp van taut string. In paragraaf 5.1 wordt uitgelegd wat taut string is en hoe het werkt. Omdat er bij taut string gewerkt wordt met een zelfgekozen penalty parameter, wordt in paragraaf 5.2 uitgelegd hoe we de optimale penalty parameter hebben gekozen. In paragraaf 5.3 wordt deze optimale penalty parameter gebruikt om de regendata met taut string op te delen in deelperiodes met een constante intensiteit. Omdat we werken met het aantal druppels per interval van 10 seconden, zal deze intensiteit een schatting zijn voor het aantal druppels per interval van 10 seconden. Deze indeling in deelperiodes met constante intensiteit wordt vervolgens in paragraaf 5.4 gebruikt om de data te toetsen op een inhomogeen Poissonproces. Belangrijk is om te realiseren dat we toetsen op een inhomogeen Poissonproces waarvan de intensiteit een stuksgewijs constante functie is.

## 5.1. Taut string methode

De taut string methode wordt gebruikt om data te benaderen met een stuksgewijs constante functie en werkt als volgt. De beschikbare data is een vector ⃗y = (y1, y2, … , ym) van lengte m. Als eerste wordt de data geïntegreerd door de cumulatieve som te berekenen, dit geeft de vector Y =⃗ (Y1, Y2, … , Ym). Daarna wordt er een bovengrens Y.upp = (Y1, Y2+β, Y3+β, … , Ym−2+β, Ym−1 + β, Ym) en een ondergrens Y.low = (Y1, Y2 − β, Y3 − β, … , Ym−2 − β, Ym−1 − β, Ym) bepaald waar de taut string tussen moet blijven. Neem nu in gedachte een stuk touw vanaf het punt Y1 tot het punt Ym en trek het touw strak tussen de boven- en ondergrens. Dit geeft een stuksgewijs lineaire functie door de punten X =⃗ (X1, X2, … , Xm). De afgeleide van X⃗ geeft de unieke vector ⃗x = (x1, x2, … , xm) die de totale variatie minimaliseert. Dit betekent dat het touw zo kort mogelijk is en wiskundig komt dit overeen met het minimaliseren van de volgende

35

36 | 5. Toetsen voor een inhomogeen Poissonproces

uitdrukking (Dümbgen en Kovac, 2009):

1
2

m
∑

i=1

(yi − xi

)

2
+ β

m
∑

i=2

|xi − xi−1| | (5.1)

De vector ⃗x is de benadering van de data. Deze benadering is stuksgewijs constant omdat het de afgeleide is van een stuksgewijs lineaire functie.
De eerste fidelity term in uitdrukking 5.1 is de l2-afstand tussen de data ⃗y en de schatting ⃗x, de tweede penalty term is een parameter β keer de totale variatie van de schatting ⃗x. β wordt ook wel de penalty parameter genoemd.

In figuur 5.1 staan drie plots van een voorbeelddataset yvb waarop taut string is uitgevoerd met een penalty parameter van 2. In figuur 5.1a staat een scatterplot van de voorbeelddata. In figuur 5.1b staat de geïntegreerde voorbeelddata Yvb (dunne zwarte lijn), de boven- en ondergrens Y.uppvb en Y.lowvb (dikke zwarte lijnen) en de taut string Xvb (blauwe lijn). Te zien is dat de taut string start in het eerste punt Yvb,1, eindigt in het laatste punt Yvb,m en daartussen strak getrokken is tussen de boven- en ondergrens. In figuur 5.1c staat nogmaals een scatterplot van de voorbeelddata yvb met dit keer de schatting xvb van de data in het blauw erbij. Te zien is dat deze schatting inderdaad stuksgewijs constant is.

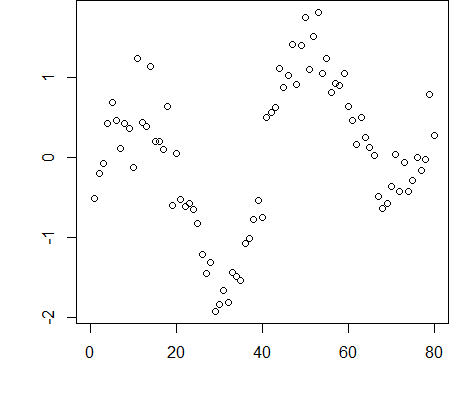
[picture p40: figure]
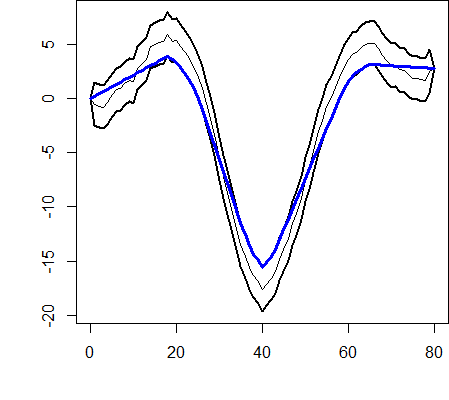
[picture p41: figure]

(a) Voorbeelddata yvb | (b) Taut string Xvb met een penalty parameter van 2

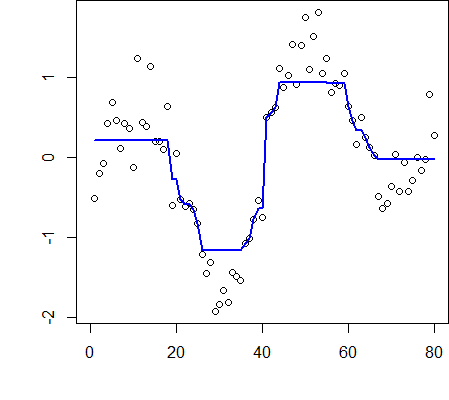
[picture p42: figure]

(c) Voorbeelddata en de geschatte intensiteit xvb voor een penalty parameter van 2

Figuur 5.1: Taut string met een penalty parameter van 2 uitgevoerd op voorbeelddata. Links staat een scatterplot van de voorbeelddata; in het midden staat de geïntegreerde data (dun zwart), de boven- en ondergrens (dik zwart) en taut string (blauw); rechts staat een scatterplot van de voorbeelddata (zwart) met de stuksgewijs constante benadering in het blauw.

Hoe nauwkeurig de schatting x is, hangt af van de penalty parameter β. De penalty parameter kan zelf gekozen worden en bepaalt de afstand tussen de boven- en ondergrens, deze afstand is namelijk twee keer de penalty parameter. Bij een penalty parameter van 0 volgt de schatting x precies de data, bij een grote penalty parameter wordt de benadering grof en op een gegeven moment zelfs constant. Dit is te zien in figuur 5.2.
Op de voorbeelddata is taut string uitgevoerd met de penalty parameters 0, 10 en 20. In de bovenste rij van figuur 5.2 staan scatterplots van de voorbeelddata yvb in het zwart, met de benadering xvb in het blauw, in de onderste rij staan plots van de geïntegreerde voorbeelddata Yvb (dunne zwarte lijn), de boven- en ondergrens (dikke zwarte lijn) en de taut string Xvb (blauwe lijn).
In de linker scatterplot 5.2a is te zien dat bij een penalty parameter van 0 de schatting precies de punten van de voorbeelddata volgt. In de plot van de geïntegreerde data 5.2d is

5.2. Taut string bepalen penalty parameter | 37

ook geen verschil te zien tussen de geïntegreerde data, de boven- en ondergrens en de taut string. In de middelste figuren is de penalty parameter 10 en bestaat de schatting Xvb uit twee constante stukken (5.2b) en de taut string Xvb uit twee lineaire stukken (5.2e). In de rechter figuren 5.2c en 5.2f is de penalty parameter 20 en is de schatting constant.
Te zien is dat bij een (te) kleine penalty parameter de schatting heel erg gaat schommelen tussen alle datapunten zoals in de scatterplot 5.2a en dat bij een (te) grote penalty parameter de schatting constant wordt zoals in scatterplot 5.2c. Tussen deze twee extremen van wil je een balans zien te vinden. Hoe deze balans gevonden kan worden, wordt uitgelegd in de volgende paragraaf.

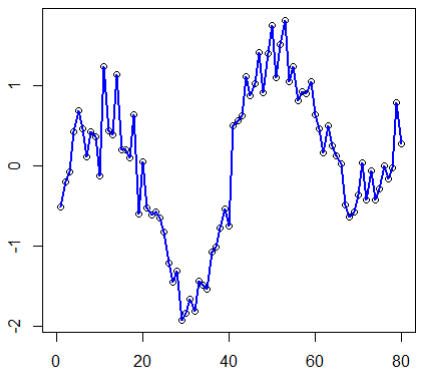
[picture p43: figure]

(a) Voorbeelddata en de geschatte intensiteit voor een penalty parameter van 0

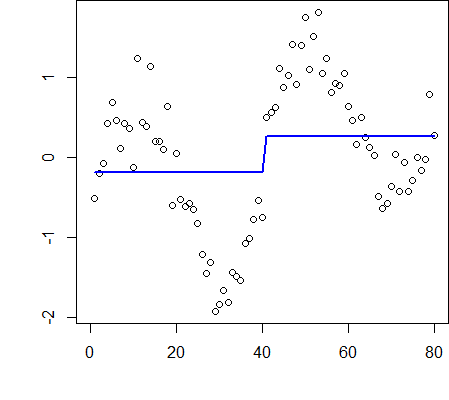
[picture p44: figure]

(b) Voorbeelddata en de geschatte intensiteit voor een penalty parameter van 10

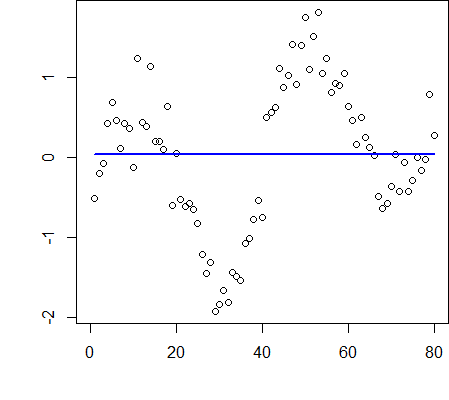
[picture p45: figure]

(c) Voorbeelddata en de geschatte intensiteit voor een penalty parameter van 20

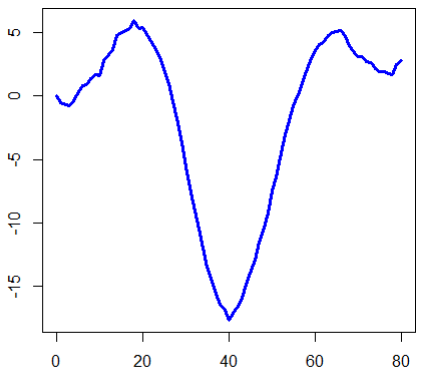
[picture p46: figure]

(d) Taut string met een penalty parameter van 0

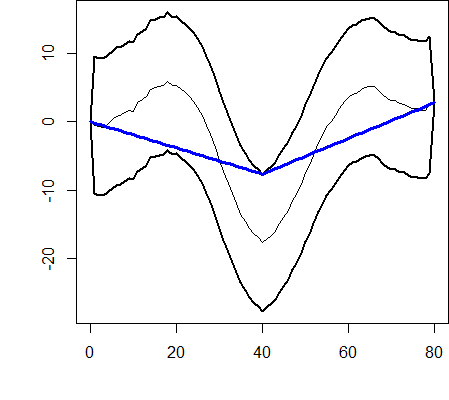
[picture p47: figure]

(e) Taut string met een penalty parameter van 10

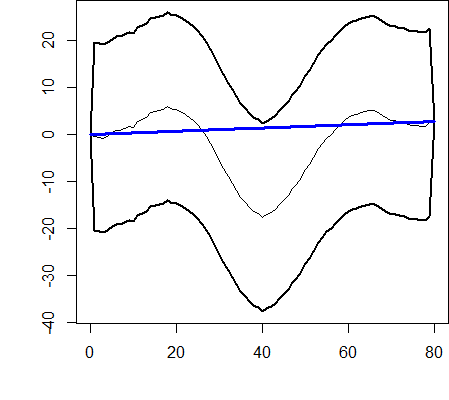
[picture p48: figure]

(f) Taut string met een penalty parameter van 20

Figuur 5.2: Taut string met een penalty parameter van 0, 10 en 20 uitgevoerd op de voorbeelddata. Boven staan scatterplots van de voorbeelddata in het zwart met de benadering in het blauw, onder staan plots van de geïntegreerde data (dun zwart), de boven- en ondergrens (dik zwart) en taut string (blauw). In de linker plots is de penalty parameters 0, in het midden 10 en rechts 20.

## 5.2. Taut string bepalen penalty parameter

Bij het uitvoeren van taut string moet er een penalty parameter gekozen worden die invloed heeft op de nauwkeurigheid van de schatting van de onderliggende functie. Het is daarom belangrijk om een goede waarde voor de penalty parameter te kiezen.
Om een goede penalty parameter te bepalen, volgen we het volgende stappenplan:
1. Kies een penalty parameter om mee te beginnen. Dit is βstart, ook wel ‘pilot’ genoemd.
2. Schat met taut string met de gekozen penalty parameter βstart de intensiteit van de data ⃗y = (y1, y2, … , ym). Dit geeft de vector ⃗xβstart = (x

(βstart)
1

, x

(βstart)
2

, … , x

(βstart)
m ), met voor

38 | 5. Toetsen voor een inhomogeen Poissonproces

ieder punt in ⃗y een schatting van de intensiteit. Neem dit als begin-intensiteit.

3. Genereer nieuwe data ⃗y

∗ = (y∗
1

, … , y∗
m) door te trekken uit Poissonverdelingen met als parameter steeds één waarde van de begin-intensiteit ⃗xβstart ⃗xβstart . We trekken uit een Poissonverdeling omdat we uiteindelijk de regendata willen toetsen op een Poissonverdeling.
4. Schat de intensiteit van de gegenereerde data ⃗y

∗ = (y∗
1

, … , y∗
m) met taut string voor
verschillende penalty parameters β1, β2, … , βN. Dit geeft de vectoren ⃗x

∗
β1

, … , ⃗x∗
βN

elk van
lengte m, met voor iedere penalty parameter βi

(i = 1, … , N) een schatting voor de intensiteit van y

∗
j met j = 1, … , m.
5. Voor iedere penalty parameter βi berekenen we de l2-afstand tussen de schatting ⃗x

∗
βi
en de begin-intensiteit ⃗xβstart .
Bij een penalty parameter van 0 zal deze afstand groot zijn, daarna neemt de afstand af voor groeiend penalty parameter maar op een zeker moment zal de afstand weer gaan stijgen als de penalty parameter nog verder toeneemt. De penalty parameter βi waarvoor deze afstand minimaal is, is de optimale penalty parameter.
6. Herhaal stap 3, 4 en 5 honderd keer. Dit doe je omdat iedere keer dat je een nieuwe dataset ⃗y

∗ = (y∗
1

, … , y∗
m) genereert, de gegenereerde data net anders is omdat je willekeurige punten uit een Poissonverdeling trekt.
7. Door stap 3, 4 en 5 honderd keer te herhalen, krijgen we honderd optimale penalty parameters. Het gemiddelde van deze honderd optimale penalty parameters gebruiken we uiteindelijk om de intensiteit van de data ⃗y = (y1, … , ym) te schatten met taut string.

Eerst zullen we bovenstaande stappen verduidelijken met een voorbeeld, daarna zullen we de stappen uitvoeren voor de regendata.

Stel we hebben een voorbeelddataset ⃗yvoorbeeld = (1, 0, 4, 7, 4, 0, 2, 5, 13, 6) en in stap 1 kiezen we βstart = 2.

In stap 2 schatten we met taut string met een penalty parameter van 2 de intensiteit van ⃗yvoorbeeld. Dit geeft de begin-intensiteit ⃗x2 = (1, 5; 1, 5; 3, 67; 3, 67; 3, 67; 3; 3; 5; 9; 8). Omdat taut string een stuksgewijs constante functie geeft kan een intensiteit meerdere keren achter elkaar voorkomen.

In stap 3 genereren we een nieuwe dataset door met het commando rpois(n, lambda) willekeurig te trekken uit Poissonverdelingen met steeds één waarde van ⃗x2. Zo krijgen we ⃗y

∗
voorbeeld = [rpois(1; | 1,5), | rpois(1; | 1,5), | rpois(1; | 3,67), | rpois(1;

3,67), rpois(1; 3,67), rpois(1; 3), rpois(1; 3), rpois(1; 5), rpois(1; 9), rpois(1; 8)]

In stap 4 schatten we met taut string met penalty parameters 0, 1, 2,…, 10 de intensiteit van ⃗y

∗
voorbeeld. Zo krijgen we elf vectoren met schattingen voor de intensiteit van voorbeeld ⃗y
| | | | | | ∗
:
⃗x

∗
0

is de intensiteit van ⃗y

∗
voorbeeld geschat met taut string met een penalty parameter van 0, ⃗x

∗
1

is de intensiteit van ⃗y

∗
voorbeeld geschat met taut string met een penalty parameter van 1, ⃗x

∗
2

is de intensiteit van ⃗y

∗
voorbeeld geschat met taut string met een penalty parameter van 2, tot en met ⃗x

∗
10, de intensiteit van ⃗y

∗
voorbeeld geschat met taut string met een penalty parameter van 10.

5.2. Taut string bepalen penalty parameter | 39

In stap 5 berekenen we de l2-afstand tussen ⃗x2 en ⃗x

∗
0

, tussen ⃗x2 en ⃗x

∗
1
| , tussen ⃗x2 en ⃗x ∗
| 2 ,
tot en met de l2-afstand tussen ⃗x2 en ⃗x

∗
10.
De waarde van β waarvoor deze afstand het kleinst is, is de optimale penalty parameter. In dit voorbeeld is de afstand tussen ⃗x2 en ⃗x

∗
4 het kleinst dus de optimale penalty parameter is hier 4.

Stap 3, 4 en 5 herhalen we honderd keer omdat ⃗y

∗
| voorbeeld steeds anders is en we daardoor
op een andere optimale penalty parameter kunnen uitkomen.
Het gemiddelde van de honderd optimale penalty parameters gebruiken we om met taut string de intensiteit van de data ⃗yvoorbeeld te schatten.

Nu gaan we de optimale penalty parameter bepalen voor de regendata ⃗yregen. Dit is een vector van lengte m = 16.734 en bestaat uit het aantal druppels per interval van 10 seconden.

### 5.2.1. Stap 1: Kies penalty parameter

Voor de regendata ⃗yregen beginnen we met een penalty parameter βstart van 5. Dus βstart = 5

### 5.2.2. Stap 2: Schat begin-intensiteit

Taut string uitvoeren op ⃗yregen geeft een vector ⃗xβstart = ⃗x5 met voor ieder interval van 10 seconden een schatting voor de intensiteit, dit zijn 16734 intensiteiten. Taut string geeft een stuksgewijs constante functie dus het zullen niet 16734 verschillende intensiteiten zijn, er zullen ook deelperiodes zijn met dezelfde intensiteit. De begin-intensiteit ⃗x5 voor de regendata ⃗yregen is weergegeven in figuur 5.3.

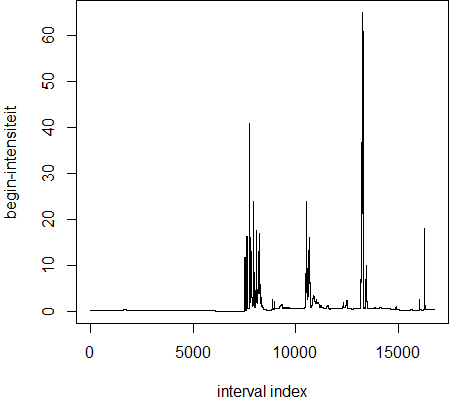
[picture p49: figure]

Figuur 5.3: De begin-intensiteit x⃗5 van de regendata y⃗regen gevonden met taut string met een gekozen penalty parameter βstart van 5.

40 | 5. Toetsen voor een inhomogeen Poissonproces

### 5.2.3. Stap 3: Trek uit Poissonverdelingen met parameters uit de begin-intensiteit

Voor iedere intensiteit in ⃗x5 trekken we met het commando rpois(n, lambda) willekeurig 1 (= n) punt uit een Poissonverdeling met lambda gelijk aan één van de intensiteiten van ⃗x5. We beginnen met de eerste intensiteit in ⃗x5 en dan nemen we steeds de volgende.
| De trekkingen zetten we allemaal achter elkaar in een vector ⃗ytextregen∗ van lengte
m =16.734. De waardes in deze vector zijn het aantal druppels in een interval van 10 seconden van de gegenereerde data. Figuur 5.4 is een plot van de gegenereerde data. Zouden we deze plot nog een keer maken, dan ziet de plot er iets anders uit. Dit komt omdat we voor het maken van ⃗y

∗
| regen willekeurige punten trekken uit een Poissonverdeling. Dus iedere keer
dat we een punt trekken kan die anders zijn dan de vorige trekking.

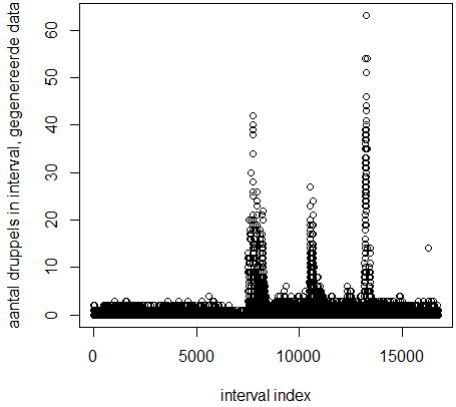
[picture p50: figure]

Figuur 5.4: Plot van de gegenereerde dataverzameling y⃗

∗
regen.

### 5.2.4. Stap 4: Bepaal penalty parameter zodat afstand begin-intensiteit en ge-

schatte intensiteit minimaal is
Nu kunnen we de gegenereerde dataverzamelingen ⃗y

∗
regen gebruiken om te bepalen bij welke penalty parameter β de afstand tussen de begin-intensiteit ⃗x5 en de intensiteit van ⃗y

∗
regen ge-
schat met taut string ⃗x

∗
β

, het kleinste is. Aanvankelijk zal de totale afstand kleiner worden voor groter wordende penalty parameters maar op een zeker moment wordt de totale afstand weer groter. Dit is te zien in figuur 5.5. Op de x-as staan de penalty parameters 0, 1, 2,…, 50, op de y-as staat de totale afstand tussen de begin-intensiteit ⃗x5 en de geschatte intensiteit van ⃗y

∗
regen, geschat met taut string met de bijbehorende penalty parameter op de x-as. Bij x=0 bijvoorbeeld, is de penalty parameter 0 en is de y-waarde de l2-afstand tussen ⃗x5 en ⃗x

∗
0
Omdat ⃗y

∗
regen elke keer anders is, berekenen we de totale afstand voor 100 verschillende gegenereerde dataverzamelingen. In figuur 5.6 is elke lijn de totale afstand tussen de begin-intensiteit ⃗x5 en de intensiteit van één van de 100 gegenereerde dataverzamelingen ⃗y

∗
regen.

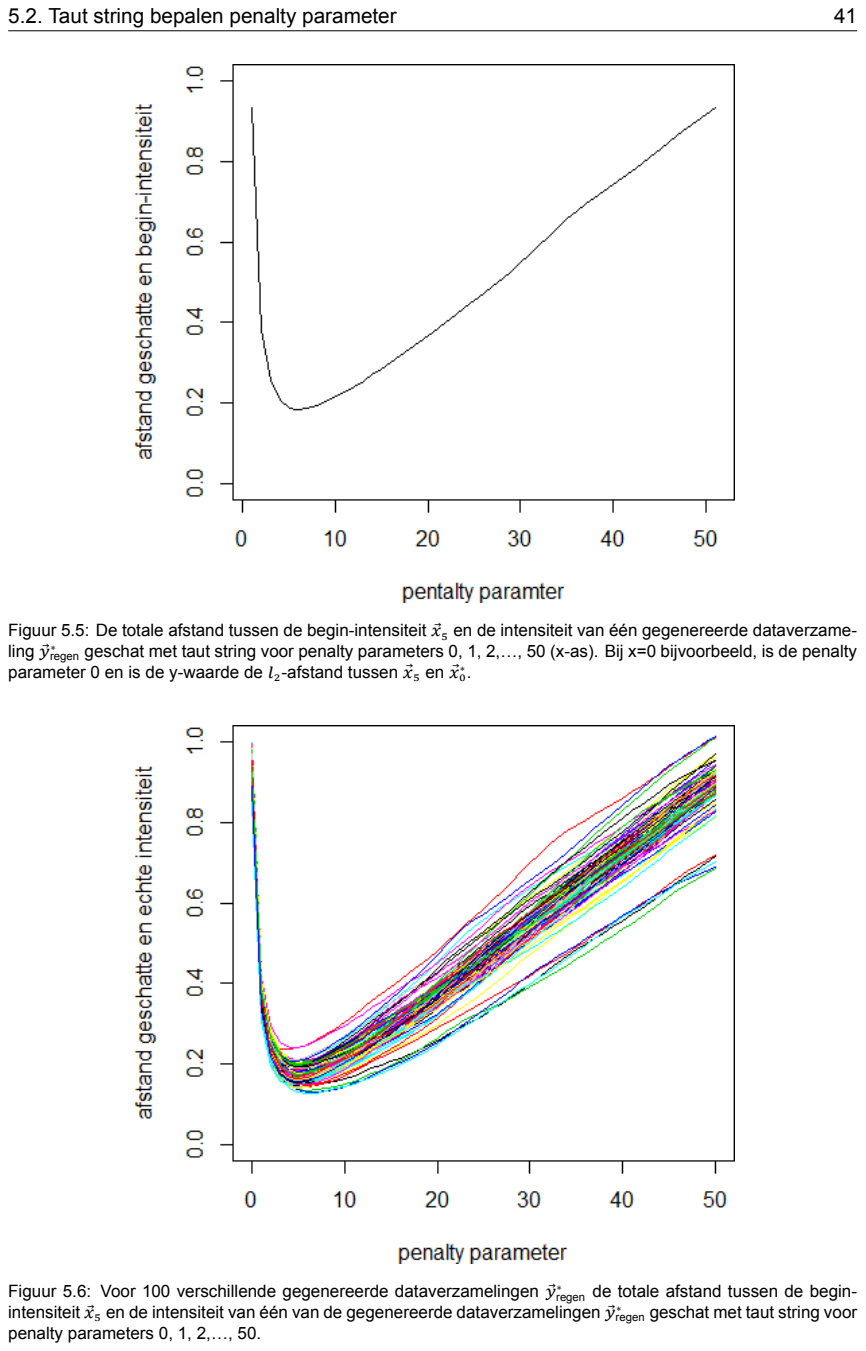
[picture p51: page 53]

5.2. Taut string bepalen penalty parameter | 41

Figuur 5.5: De totale afstand tussen de begin-intensiteit x⃗5 en de intensiteit van één gegenereerde dataverzameling y⃗

∗
regen geschat met taut string voor penalty parameters 0, 1, 2,…, 50 (x-as). Bij x=0 bijvoorbeeld, is de penalty parameter 0 en is de y-waarde de l2

-afstand tussen x⃗5 en x⃗

∗
0

Figuur 5.6: Voor 100 verschillende gegenereerde dataverzamelingen y⃗

∗
regen de totale afstand tussen de begin-intensiteit x⃗5 en de intensiteit van één van de gegenereerde dataverzamelingen y⃗

∗
regen geschat met taut string voor penalty parameters 0, 1, 2,…, 50.

42 | 5. Toetsen voor een inhomogeen Poissonproces
| Voor elke gegenereerde dataverzameling ⃗y ∗ regen in figuur 5.6 lijkt de minimale afstand zich
rond een penalty parameter van 5 te bevinden Dit zou dus betekenen dan de optimale penalty parameter rond de 5 ligt.
| In figuren 5.7b en 5.7a staan een boxplot en een histogram van de optimale penalty para-
meter van elk van de 100 verschillende gegenereerde dataverzamelingen ⃗y
| ∗ regen. Hieruit blijkt
inderdaad dat de optimale penalty parameter voor de verschillende individuele gesimuleerde datasets ⃗y

∗
| regen zich concentreert rond 5. Het gemiddelde van de optimale penalty parameter
van elk van de 100 verschillende gegenereerde dataverzamelingen ⃗y
| ∗ regen is 4,92. Omdat we nu de afstand hebben bepaald voor penalty parameters 0, 1, 2,…, 50, is de

optimale penalty parameter altijd een geheel getal. Daarom heeft figuur 5.7 alleen waardes bij de gehele getallen.

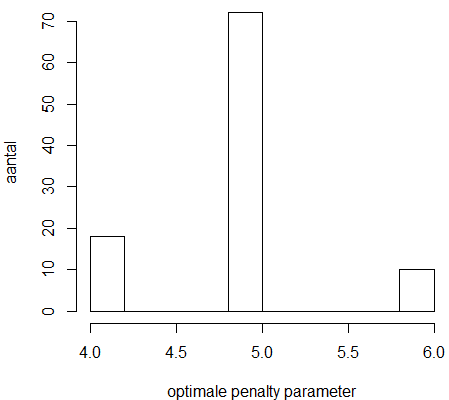
[picture p52: figure]

(a) Histogram van de penalty parameter waarvoor de afstand minimaal is voor 100 verschillende gegenereerde dataverzamelingen y⃗

∗
regen.
De linker staaf is het aantal keer dat de optimale penalty parameter 4 is, de tweede is voor penalty parameter 5 en de laatste voor 6.

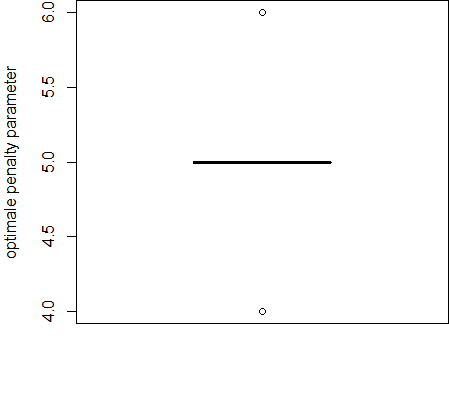
[picture p53: figure]

(b) Boxplot van de penalty parameter waarvoor de afstand minimaal is voor 100 verschillende gegenereerde dataverzamelingen y⃗

∗
regen.

Figuur 5.7: Histogram en boxplot van de optimale penalty parameters voor 100 verschillende gegenereerde dataverzamelingen y⃗

∗
regen. Omdat we nu werken met gehele getallen als penalty parameters, is de optimale penalty parameter ook altijd een geheel getal waardoor voor de regendata alleen de waardes 4, 5 en 6 voorkomen.

Nu we op helen nauwkeurig hebben bepaald wat de optimale penalty parameters voor de regendata ⃗yregen zijn, zijn er drie mogelijkheden waar het minimum van de afstand zich kan bevinden, namelijk: op de gevonden waarde; net voor de gevonden waarde; of net na de gevonden waarde. Dit is gevisualiseerd in figuur 5.8 en belangrijk om te weten als we de optimale penalty parameter op één of meerdere decimalen nauwkeurig willen bepalen.
Uit figuren 5.7a en 5.7b wordt duidelijk dat de afstand tussen de begin-intensiteit en de geschatte intensiteit voor de 100 verschillende gegenereerde dataverzamelingen ⃗y

∗
regen minimaal
is voor penalty parameters van 4, 5 en 6. Dat betekent dat de optimale penalty parameters zich tussen 3 en 7 kunnen bevinden.

Om op één decimaal nauwkeurig te bepalen waar de optimale penalty parameter zich bevindt gaan we als volgt te werk. We weten dat de optimale penalty parameter zich tussen de 3 en 7 bevindt. Daarom gaan we voor dezelfde 100 gegenereerde dataverzamelingen ⃗y

∗
regen
als eerder de intensiteit schatten met taut string maar nu met penalty parameters van 3,0, 3,1, 3,2,..., 6,8, 6,9 en 7,0. Voor iedere gegenereerde dataverzameling ⃗y

∗
regen en iedere penalty
parameter β berekenen we de afstand tussen de begin-intensiteit ⃗x5 en de geschatte intensiteit

5.2. Taut string bepalen penalty parameter | 43

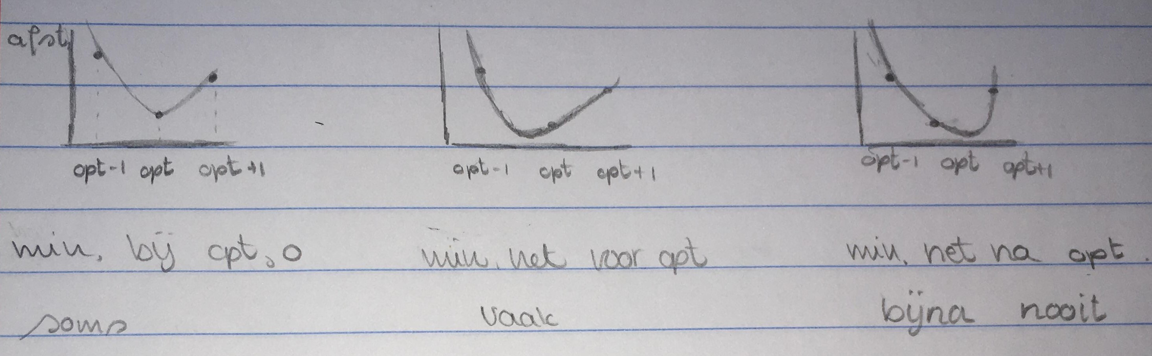
[picture p54: figure]

Figuur 5.8: Drie mogelijkheden waar het minimum zich kan bevinden. V.l.n.r.: op de laatste waarde, net voor de laatste waarde, net na de laatste waarde.

⃗x

∗
β

. De penalty parameter waarvoor deze afstand minimaal is, nemen we als optimale penalty parameter.
Zo krijgen we 100 optimale penalty parameters met één decimaal. In figuur 5.9a staat een histogram van de penalty parameter waarvoor de afstand minimaal is voor de 100 verschillende gegenereerde dataverzamelingen ⃗y

∗
regen. De linker staaf is het aantal keer dat de optimale penalty parameter 3,6, 3,7 en 3,8 is, de tweede is voor 3,9 en 4,0, de derde voor 4,1 en 4,2 en zo door tot de laatste staaf die bij penalty parameters 5,9 en 6,0 hoort. Te zien is dat een optimale penalty parameter van 4,9 of 5,0 het vaakst (namelijk 20 keer) voorkomt. Uit figuur 5.9b kunnen we afleiden dat de mediaan van de optimale penalty parameters 4,9 is. Berekenen we het gemiddelde van de 100 optimale penalty parameters dan komen we uit op een waarde van 4,895.

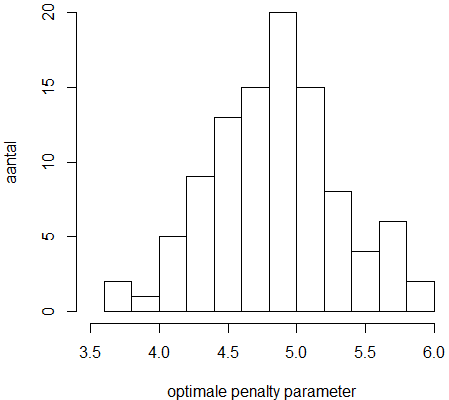
[picture p55: figure]

(a) Histogram van de penalty parameter waarvoor de afstand minimaal is voor 100 verschillende gegenereerde dataverzamelingen y⃗

∗
regen.
De linker staaf is het aantal keer dat de optimale penalty parameter 3,6, 3,7 en 3,8 is, de tweede is voor 3,9 en 4,0, de derde voor 4,1 en 4,2 en zo door tot de laatste staaf die bij penalty parameters 5,9 en 6,0 hoort.

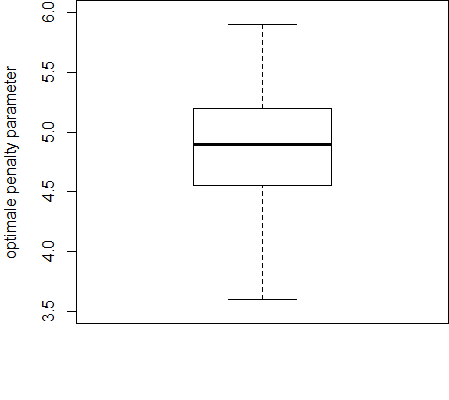
[picture p56: figure]

(b) Boxplot van de penalty parameters waarvoor de afstand minimaal is voor 100 verschillende gegenereerde dataverzamelingen y⃗

∗
regen

Figuur 5.9: Histogram en boxplot van de optimale penalty parameters voor 100 verschillende gegenereerde dataverzamelingen y⃗

∗
regen.

Bij de optimale penalty parameters van figuur 5.7a komen we uit op een gemiddelde van

44 | 5. Toetsen voor een inhomogeen Poissonproces

4,92 en bij de penalty parameters van 5.9a op een gemiddelde van 4,895. Om de intensiteit van de regendata ⃗yregen te schatten met taut string lijkt een penalty parameter van 4,9 daarom een goede keuze.

### 5.2.5. Effect van de gekozen penalty parameter in stap 1

In stap 1 kiezen we een waarde voor de penalty parameter βstart om mee te starten. Met die penalty parameter voeren we taut string uit op de regendata ⃗yregen. De intensiteit die hier uit komt, gebruiken we als begin-intensiteit ⃗xβstart om vervolgens de optimale penalty parameter te bepalen. Wat is het effect van deze gekozen penalty parameter βstart op de uiteindelijke optimale penalty parameter?
| Om dit te onderzoeken, hebben we vijf verschillende waardes gekozen voor de penalty
parameter βstart, namelijk 1, 5, 10, 20 en 50. Voor deze 5 verschillende waardes van βstart hebben we stap 1 tot en met 7 die aan het begin van deze paragraaf 5.2 staan, uitgevoerd. Zo krijgen we voor iedere waarde van βstart honderd optimale penalty parameters, voor iedere gegenereerde dataverzameling ⃗y

∗
| regen één. Voor deze 100 penalty parameters kijken we naar
de gemiddelde waarde, de minimale waarde en de maximale waarde. Dit staat in tabel 5.1. Te zien is dat de gekozen waarde van βstart zeker een effect heeft op de uiteindelijke optimale penalty parameter.
| Wat positief opvalt is dat voor kleine waardes van βstart, zoals 1, de optimale penalty pa-
rameter groter is dan βstart en dat voor grote(re) waardes van βstart, zoals 10, 20 en 50, de optimale penalty parameter kleiner is dan βstart. De optimale penalty parameter neemt dus toe voor grotere start penalty parameter βstart, maar de groei lijkt wel minder hard te gaan voor groter waardes van βstart.
| Wat ook opvalt is dat voor βstart = 5 de waarde van de optimale penalty parameter 4,9 is
en daarmee bijna gelijk aan de start penalty parameter.

Tabel 5.1: Voor vijf verschillende waardes van βstart en voor honderd verschillende gegenereerde datasets y⃗

| ∗ regen
het gemiddelde, het minimum en het maximum van de optimale penalty parameters.
βstart | gemiddelde | minimum | maximum
1 5 10 20 50 | 2,9 4,9 6,2 7,5 10,5 | 2,2 3,6 4,8 5,5 7,5 | 3,9 7,1 7,9 9,9 13,4

Uit tabel 5.1 komt niet heel duidelijk één waarde voor de start penalty parameter βstart naar voren. Daarom bepalen we op het oog voor welke waarde van βstart de fit van de intensiteit redelijk is en voor welke waarde de fit slecht is. Met taut string schatten we de intensiteit van de regendata ⃗yregen voor penalty parameters 1, 5, 10, 20 en 50. Dit geeft de vijf vectoren ⃗x1, ⃗x5, ⃗x10, ⃗x20 en ⃗x50. Met plotjes van ⃗yregen en deze verschillende intensiteiten kunnen we op het oog bepalen voor welke penalty parameter de schatting redelijk is en voor welke penalty parameters de schatting slecht is.

Voor de vijf verschillende schattingen van de intensiteit van de regendata plotten we in de linker figuren van de figuren 5.10 t/m 5.14 alle regendata ⃗yregen in het zwart en de geschatte intensiteit ⃗xβ met β =1, 5, 10, 20 en 50 in het rood; in de middelste figuren is het eerste redelijk constante stuk van de regendata y1, … , y7500 (de eerste 7500 intervallen) geplot met de intensiteit; in de rechter figuren is de eerste piek van de regendata y7500, … , y8500 (intervallen met index 7500 tot 8500) geplot met de intensiteit.

5.2. Taut string bepalen penalty parameter | 45

In figuur 5.10 is te zien dat met een penalty parameter van 1 de schatting van de intensiteit veel heen en weer springt tussen de datapunten. Ook voor het constante stuk van de data, schommelt de intensiteit behoorlijk (zie figuur 5.10b). Een penalty parameter van 1 lijkt dus te klein voor een goede fit van de schatting.

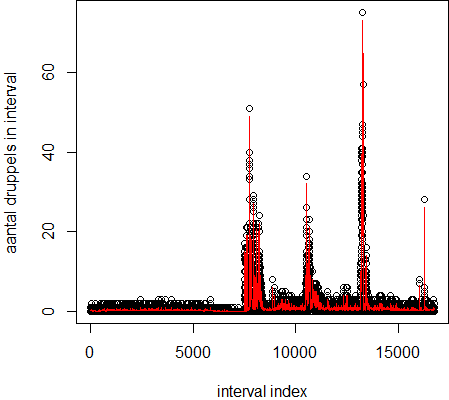
[picture p57: figure]
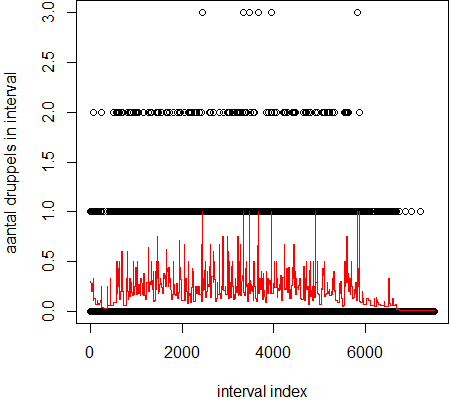
[picture p58: figure]

(a) Alle data y⃗regen | (b) Constante stuk, y1

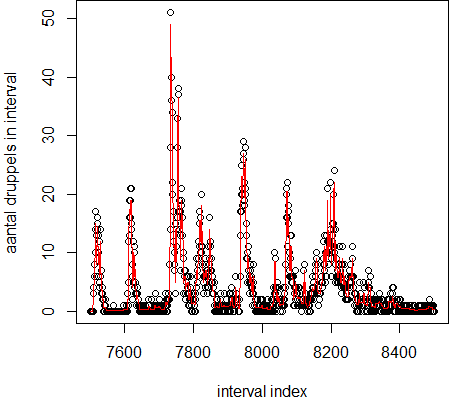
[picture p59: figure]

, … , y7500 | (c) Eerste piek, y7500, … , y8500

Figuur 5.10: Intensiteit van de data (rood) geschat met taut sting met een penalty parameter van 1.

Voor de intensiteiten geschat met een penalty parameter van 5, 10 en 20 ziet de fit er redelijk goed uit. Op het constante stuk van de data schommelt de intensiteit voor een penalty parameter van 5 (figuur 5.11b) nog wel wat meer dan voor 10 en 20 (figuren 5.12b en 5.13b) maar niet buitenproportioneel veel. Voor de eerste piek (figuren 5.11c, 5.12c en 5.13c) ziet de schatting van de intensiteit er ook redelijk uit voor alle drie de penalty parameters. De fit van de geschatte intensiteit lijkt dus redelijk te zijn voor penalty parameters 5, 10 en 20.

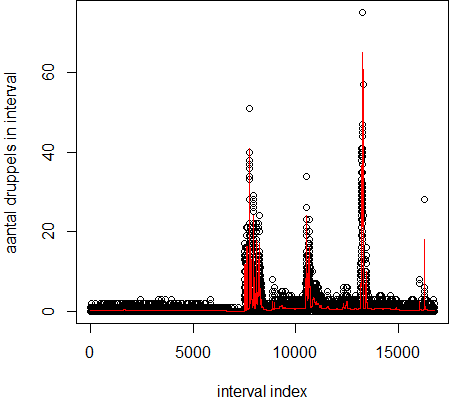
[picture p60: figure]
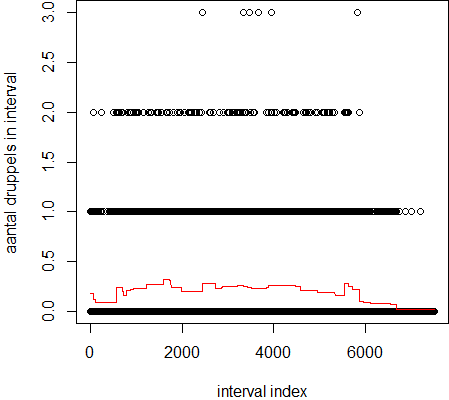
[picture p61: figure]

(a) Alle data y⃗regen | (b) Constante stuk, y1

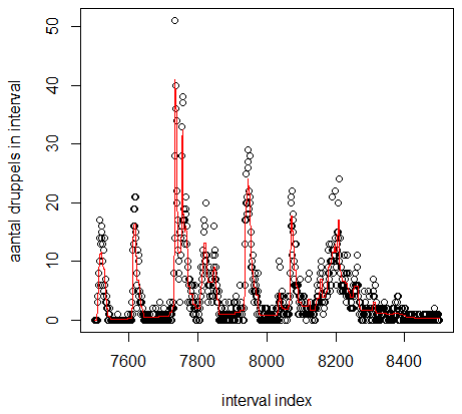
[picture p62: figure]

, … , y7500 | (c) Eerste piek, y7500, … , y8500

Figuur 5.11: Intensiteit van de data (rood) geschat met taut sting met een penalty parameter van 5.

Bij een penalty parameter van 50 wordt de schatting wat grof. Voor de intensiteit van het constante stuk in figuur 5.14b is er misschien weinig verschil te zien met de schatting met een penalty parameter van 20 in figuur 5.13b maar kijken we naar de schatting van de intensiteit van de eerste piek dan is er wel een duidelijk verschil tussen een penalty parameter van 50 in figuur 5.14c en 20 in figuur 5.13c. Zo zijn er net voor interval index 7800 twee pieken (het lijkt bijna één piek) in het aantal druppels per interval. Bij een penalty parameter van 50 wordt de intensiteit van deze pieken geschat met één piek (zie figuur 5.14c) terwijl bij een penalty parameter van 20 (en kleiner) de intensiteit wordt geschat met twee pieken (zie figuur 5.13c. Een penalty parameter van 50 lijkt dus te groot voor een goede fit van de schatting van de intensiteit.

46 | 5. Toetsen voor een inhomogeen Poissonproces

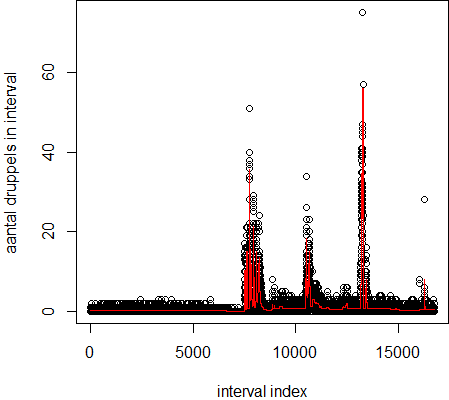
[picture p63: figure]
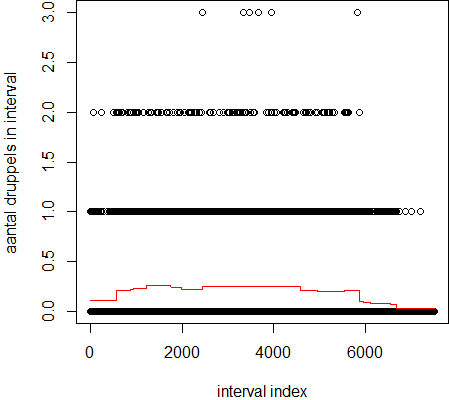
[picture p64: figure]

(a) Alle data y⃗regen | (b) Constante stuk, y1

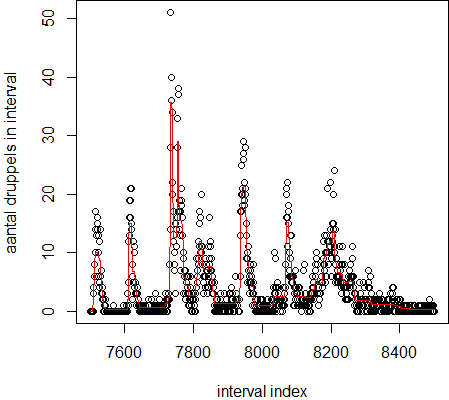
[picture p65: figure]

, … , y7500 | (c) Eerste piek, y7500, … , y8500

Figuur 5.12: Intensiteit van de data (rood) geschat met taut sting met een penalty parameter van 10.

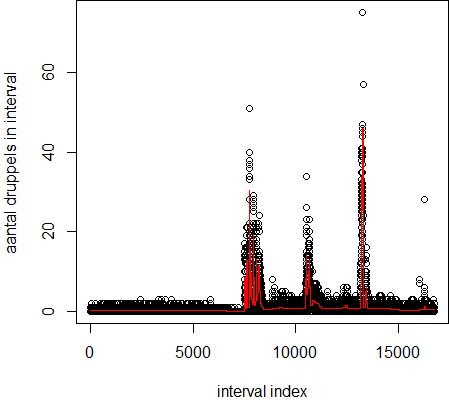
[picture p66: figure]
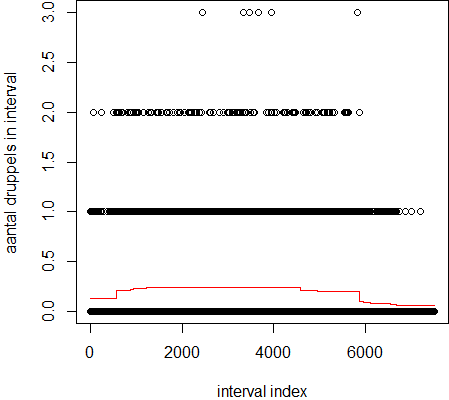
[picture p67: figure]

(a) Alle data y⃗regen | (b) Constante stuk, y1

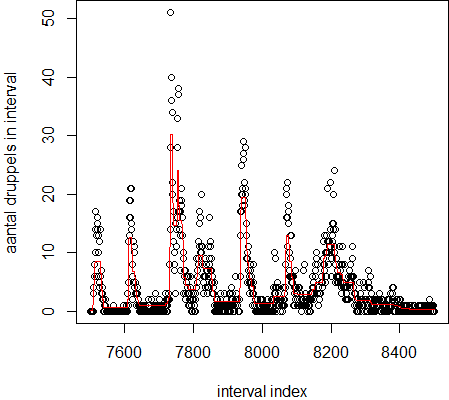
[picture p68: figure]

, … , y7500 | (c) Eerste piek, y7500, … , y8500

Figuur 5.13: Intensiteit van de data (rood) geschat met taut sting met een penalty parameter van 20.

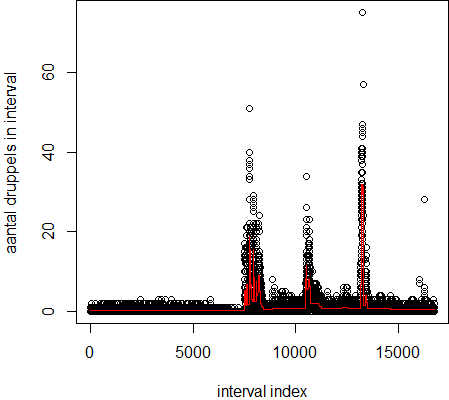
[picture p69: figure]
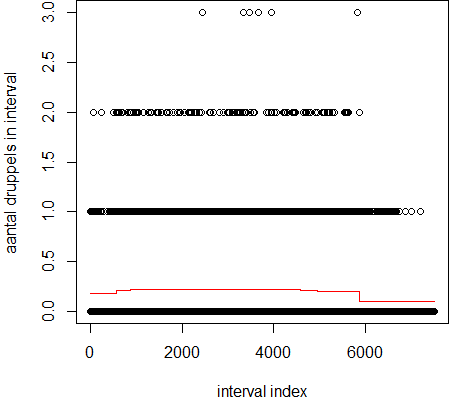
[picture p70: figure]

(a) Alle data y⃗regen | (b) Constante stuk, y1

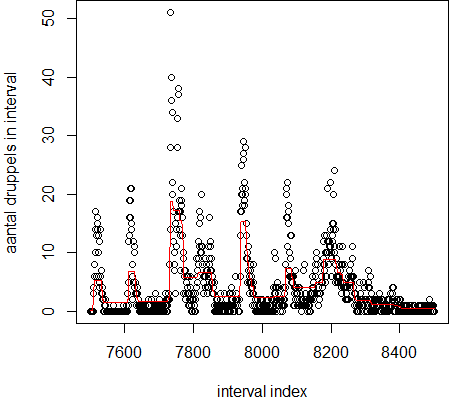
[picture p71: figure]

, … , y7500 | (c) Eerste piek, y7500, … , y8500

Figuur 5.14: Intensiteit van de data (rood) geschat met taut sting met een penalty parameter van 50.

Schatten we de intensiteit van de regendata met taut string met een penalty parameter van 5, 10 of 20 dan lijken we een redelijke fit te hebben maar voor penalty parameters 1 en 50 lijkt de fit niet goed te zijn. Daarom focussen we ons nu op penalty parameters 5, 10 en 20.

Nemen we βstart gelijk aan 5, 10 en 20 dan krijgen we als gemiddelde optimale penalty parameters 4,9, 6,2 en 7,5 (zie tabel 5.1). Nemen we het gemiddelde van de drie gemiddelde optimale penalty parameters dan komen we op een penalty parameter van 6,2. Daarom kiezen we ervoor om de intensiteit van de regendata te schatten met taut string met een penalty parameter van 6,2.

5.3. Intensiteit van de regendata schatten met taut string | 47

## 5.3. Intensiteit van de regendata schatten met taut string

In de vorige paragraaf hebben we de keuze gemaakt om met een penalty parameter van 6,2 de intensiteit van de regendata ⃗yregen te schatten. Daarvoor voeren we taut string met de gekozen penalty parameter uit op de data. Dit geeft per interval van 10 seconden een schatting x

(6,2)
1

, x

(6,2)
2

, … , x

(6,2)
m voor de intensiteit. In figuur 5.15 staat een plot van de regendata in het zwart en de geschatte intensiteit in het rood.

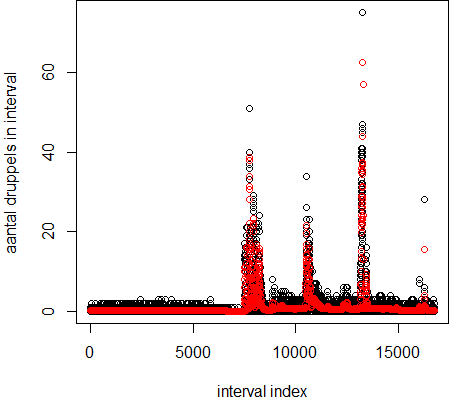
[picture p72: figure]

Figuur 5.15: De regendata y⃗regen (zwart) en de geschatte intensiteit x⃗6,2 (rood). De intensiteit is geschat met taut string met een penalty parameter van 6,2.

In figuur 5.15 lijkt het misschien alsof de geschatte intensiteit vanaf het begin tot aan de eerste piek constant is. Vergroten we de intensiteit in de eerste 7500 intervallen echter uit, zoals in figuur 5.16, dan is duidelijk te zien dat de intensiteit een stuksgewijs constante functie is en wel degelijk van waarde verandert in het eerste gedeelte van de data.

48 | 5. Toetsen voor een inhomogeen Poissonproces

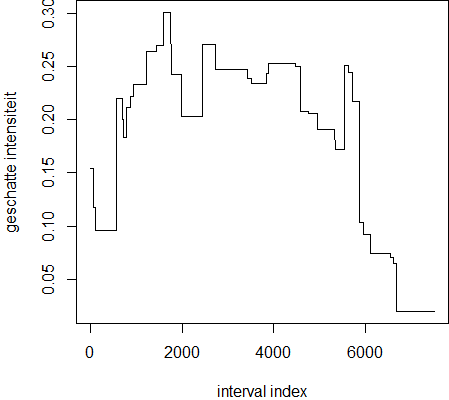
[picture p73: figure]

Figuur 5.16: De intensiteit van de eerste 7500 intervallen van 10 seconden van de data, geschat met taut string met een penalty parameter van 6,2

## 5.4. De data toetsen op een inhomogeen Poisson proces

Omdat taut string een stuksgewijs constante functie geeft, zullen er meerdere intervallen achter elkaar zijn met dezelfde intensiteit. Zo ontstaan er deelperiodes in de regendata met dezelfde intensiteit. Deze deelperiodes kunnen we toetsen op het hebben van een Poissonverdeling met intensiteit gelijk aan de intensiteit geschat met taut string.

Net als in paragraaf 4.7 is de nulhypothese H0 ∶ het aantal regendruppels per tijdsinterval volgt een Poissonverdeling met constante intensiteit. Omdat we met een Poissonverdeling werken, is het verwachte aantal druppels per interval gelijk aan de intensiteit van de Poissonverdeling.
Als de nulhypothese niet wordt verworpen, dan kan het aantal druppels per interval homogeen Poisson-verdeeld zijn met parameter gelijk aan de geschatte intensiteit. Dit betekent dat de data dan met een homogeen Poissonproces kan worden beschreven met dezelfde parameter als die van de Poissonverdeling.
Als we de nulhypothese dus niet verwerpen voor een bepaalde deelperiode van de regendata, dan kan die deelperiode van de regendata met een homogeen Poissonproces worden beschreven. Wordt de nulhypothese voor meerdere deelperiodes achter elkaar niet verworpen, dan hebben we meerdere deelperiodes achter elkaar die met een homogeen Poisson proces kunnen worden beschreven maar met verschillende intensiteiten. Al deze deelperiodes samen kunnen dan met een inhomogeen Poissonproces met stuksgewijs constante intensiteit worden beschreven.

Om de regendata te toetsen op een inhomogeen Poissonproces met stuksgewijs constante

5.4. De data toetsen op een inhomogeen Poisson proces | 49

intensiteit gaan we als volgt te werk. Met taut string wordt de data opgedeeld in meerdere deelperiodes met dezelfde intensiteit. Voor deze deelperiodes kunnen we op eenzelfde manier als in subparagraaf 4.7.5 toetsen of het aantal druppels per interval homogeen Poisson-verdeeld kan zijn of niet.
Met een penalty parameter van 6,2 wordt de regendata opgedeeld in 474 deelperiodes met een constante intensiteit. In figuur 5.17 is de regendata geplot en is iedere deelperiode met een eigen kleur aangegeven. In de eerste 7500 intervallen zijn de verschillende deelperiodes nog redelijk goed te onderscheiden maar in de pieken worden de deelperiodes korter en zijn ze minder goed van elkaar te onderscheiden.

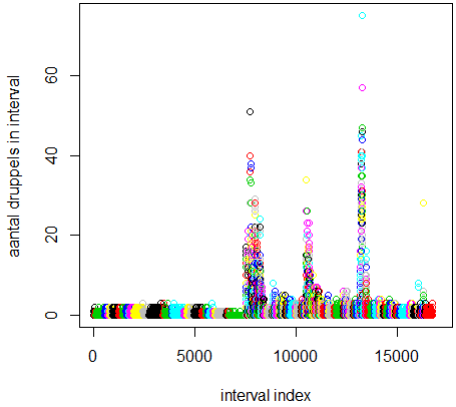
[picture p74: figure]

Figuur 5.17: De 474 deelperiodes waain de regendata met taut string met een penalty parameter van 6,2 is verdeeld.

Voor elke deelperiode voeren we net als in paragraaf 4.7.5 een parametrische bootstrapsimulatie uit. Als eerste schatten we de intensiteit van de deelperiode met het steekproefgemiddelde. Daarna trekken we net zoveel punten uit een Poissonverdeling met parameter gelijk aan het steekproefgemiddelde als de deelperiode intervallen heeft. Dit doen we 100.000 keer voor iedere deelperiode omdat we er voor gekozen hebben om simulaties uit te voeren met 100.000 runs. De p-waarde kunnen we nu berekenen door de fractie te nemen van de waardes van de toetsingsgrootheid van de trekking die groter zijn dan de waarde van de toetsingsgrootheid van de deelperiode.
We werken weer met een significantieniveau van 5% en daarom wordt de nulhypothese verworpen als de p-waarde kleiner is dan 0.05. Voor 26 van de deelperiodes wordt de nulhypothese verworpen, voor 448 deelperiodes wordt de nulhypothese niet verworpen. In figuur 5.18 staat een weergave van de regendata. In figuur 5.18a staat alleen de regendata, in figuur 5.18b staat de regendata en de intensiteit geschat met taut string met een penalty parameter van 6,2. Voor het aantal druppels in de groene intervallen wordt de nulhypothese niet verwor-

50 | 5. Toetsen voor een inhomogeen Poissonproces

pen op basis van de gevonden p-waardes in de simulatie, voor het aantal druppels in de rode intervallen wel.

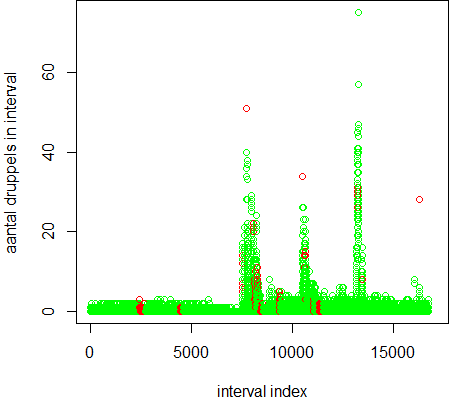
[picture p75: figure]
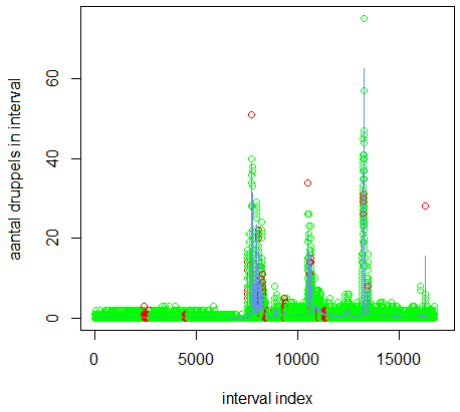
[picture p76: figure]

(a) (b)

Figuur 5.18: Het aantal druppels per interval. Op de x-as staat de index van het interval, op de y-as het aantal druppels in het interval. Voor de groene punten wordt de nulhypothese niet verworpen; voor de rode punten wel. Links is alleen de data weergegeven, rechts is naast de data ook de geschatte intensiteit weergegeven. De intensiteit is de intensiteit van de regendata geschat met taut string met een penalty parameter van 6,2.

Ten opzichte van figuur 4.4 zijn er meer stukken van de data die homogeen Poisson-verdeeld kunnen zijn. Zelfs van de hoge pieken zijn er stukken die homogeen Poisson-verdeeld kunnen zijn. Opvallend is dat voor het hoogste punt van de eerste, tweede en vierde piek de nulhypothese wel wordt verworpen maar voor het hoogste punt van de derde piek niet. Waar dat aan ligt is niet helemaal duidelijk. Alle vier de hoogste intervallen van de pieken vormen namelijk een ‘eigen deelperiode’ in de regendata. De intervallen hebben een bepaalde geschatte intensiteit en de intervallen daar net voor en net na hebben een andere intensiteit. De hoogste intervallen van de vier pieken hebben dus allemaal een eigen intensiteit.

In principe verwerp je voor één interval nooit dat het aantal druppels in dat interval Poisson-verdeeld is maar voor de regendata gebeurt dit toch. Het is dus best bijzonder dat we voor de regendata verwerpen dat het aantal druppels in één interval Poisson-verdeeld is maar wat het nog merkwaardiger maakt is dat we voor sommige interval wel en voor andere intervallen niet verwerpen dat het aantal druppels Poisson-verdeeld is. Nou kan dat misschien te maken hebben met het verschil tussen het aantal druppels in een interval en de geschatte intensiteit voor dat interval. In het hoogste interval van de eerste piek zijn er bijvoorbeeld 51 regendruppels gevallen en is de geschatte intensiteit 38,6, dit is een verschil van 12,4. Kijken we voor de drie andere pieken ook naar het verschil tussen het aantal druppel in het hoogste interval en de geschatte intensiteit dan is dat ook allemaal 12,4. Het verschil is dus overal hetzelfde maar het quotiënt van het aantal druppels en de geschatte intensiteit is wel verschillend voor de vier pieken. Voor de eerste piek is dit 1,321, voor de tweede 1,574, voor de derde 1,198 en voor de vierde 1,794. De grootte van het quotiënt is dus waarschijnlijk de reden waarom voor piek één, twee en vier wel wordt verworpen dat het aantal druppels homogeen Poisson-verdeeld is en voor piek drie niet.

5.4. De data toetsen op een inhomogeen Poisson proces | 51

### 5.4.1. Conclusie wel of niet inhomogeen Poisson

De regendata bestaat in totaal uit 16.734 intervallen van 10 seconden. Met taut string worden deze intervallen verdeeld in 474 deelperiodes met een constante intensiteit die per deelperiode verschilt. Voor 26 van deze deelperiodes wordt verworpen dat het aantal druppels per interval homogeen Poisson-verdeeld is, voor de andere 448 deelperiodes wordt niet verworpen dat het aantal druppels per interval homogeen Poisson-verdeeld is. Zoals in figuur 5.18 te zien is, zijn er meerdere deelperiodes (de groene) met verschillende intensiteit achter elkaar waarvoor het aantal druppels per interval homogeen Poisson-verdeeld kan zijn. Dit betekent dat voor die deelperiodes de regenval met een inhomogeen Poissonproces kan worden beschreven.

Belangrijk is om te beseffen dat we er nu voor gekozen hebben om de intensiteit van de regen te schatten met een stuksgewijs constante functie met taut string met een penalty parameter van 6,2. De gemiddelde lengte van de deelperiodes met constante intensiteit is 36 intervallen van 10 seconden, maar van de 474 deelperiodes zijn er ook 297 die bestaan uit tien intervallen of minder. Voor deze deelperiodes zal de nulhypothese niet snel worden verworpen. Het zou dus kunnen dat voor bepaalde deelperiodes niet wordt verworpen dat het aantal druppels per interval homogeen Poisson-verdeeld is terwijl dat eigenlijk wel zou moeten.
Het zou ook kunnen dat een andere intensiteit, bijvoorbeeld een gladde functie, beter bij de regendata past. Dat hebben we niet onderzocht en is mogelijk nog wel interessant als vervolg.

6

# Conclusie en Discussie

In deze scriptie is onderzocht of een Poissonproces, homogeen of inhomogeen, een redelijk model is om regenbuien in Afrika mee te modelleren.

De onderzochte regenbui is opgenomen op Pole Pole vanaf 1 mei 12 uur tot 3 mei 10:30 uur. Deze periode noemen we de observatieperiode. Als eerste is onderzocht of de regen in de gehele observatieperiode kan worden beschreven met een homogeen Poissonproces oftewel een Poissonproces met constante intensiteit.

Met een parametrische bootstrapsimulatie is gevonden dat voor alle regen in de gehele observatieperiode samen de p-waarde 0 is. Dit betekent dat bij ieder significantieniveau wordt verworpen dat de regen in de gehele observatieperiode met een homogeen Poissonproces kan worden beschreven. Een homogeen Poissonproces is dus niet een redelijk model om regenbuien in Afrika mee te modelleren.

Er zijn wel deelperiodes van de observatieperiode waarin de regen met een homogeen Poissonproces kan worden beschreven. Om dit te onderzoeken is de observatieperiode op het oog opgedeeld in vijftien deelpriodes met een redelijk constant-lijkende intensiteit zoals te zien is in figuur 6.1a.

Voor iedere deelperiode voeren we een parametrische bootstrapsimulatie uit zoals ook voor de gehele observatieperiode gedaan is. Met een significatieniveau van 5%, wordt voor zes van de vijftien deelperiodes verworpen dat de regen met een homogeen Poissonproces kan worden beschreven, voor de andere negen deelperiodes wordt dit niet verworpen en kan de regen dus wel met een homogeen Poissonproces worden beschreven. In figuur 6.1b kan de regen in de groene stukken wel worden beschreven met een homogeen Poissonproces en de regen in de rode stukken niet. Regen met een lage intensiteit kan dus wel met een homogeen Poissonproces worden beschreven maar regen met een hoge(re) intensiteit niet.

Dat er in figuur 6.1 meerdere deelperiodes zijn waarin de regen met een homogeen Poissonproces kan worden beschreven, is een aanwijzing dat de regen misschien met een inhomogeen Poissonproces kan worden beschreven. Om dit objectiever te onderzoeken is de data met taut string opgedeeld in 474 deelperiodes met een constante intensiteit die per deelperiode anders is. Deze deelperiodes zijn in figuur 6.2a weergegeven met een eigen kleur.

53

54 | 6. Conclusie en Discussie

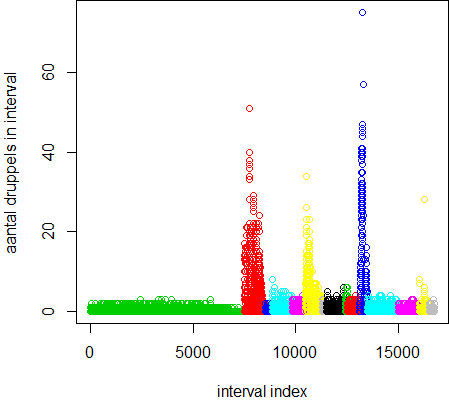
[picture p77: figure]

(a) De vijftien deelperiodes waarin de regendata op het oog is verdeeld.

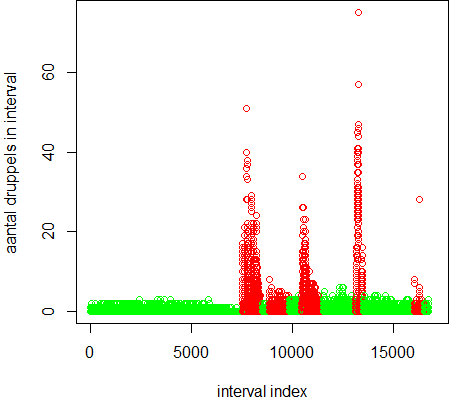
[picture p78: figure]

(b) De deelperiodes waarin de regen wel met een homogeen Poissonproces kan worden beschreven in het groen en de deelperiodes waarin de regen niet met een homogeen Poissonproces kan worden beschreven in het rood.

Figuur 6.1

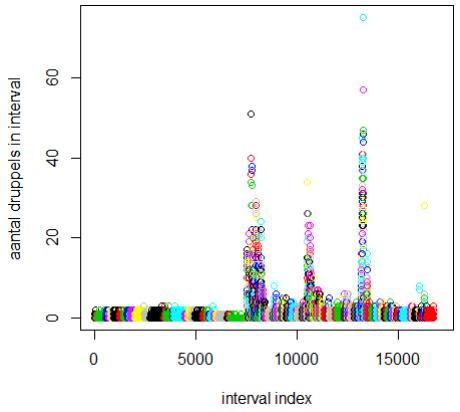
[picture p79: figure]

(a) De 474 deelperiodes waarin de regendata met taut string met een penalty parameter van 6,2 is verdeeld.

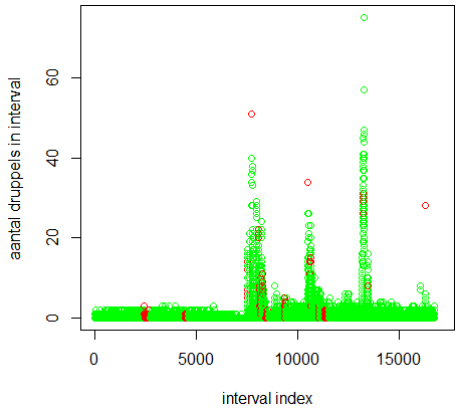
[picture p80: figure]

(b) De deelperiodes waarin de regen wel met een homogeen Poissonproces kan worden beschreven in het groen en de deelperiodes waarin de regen niet met een homogeen Poissonproces kan worden beschreven in het rood.

Figuur 6.2

Voor iedere deelperiode wordt weer een parametrische bootstrapsimulatie uitgevoerd waarmee de p-waarde wordt bepaald. Met een significantieniveau van 5% wordt voor 26 van de 474 deelperiodes verworpen dat de regen met een homogeen Poissonproces kan worden beschreven (de rode stukken in figuur 6.2b), voor de andere 448 deelperiodes wordt dit niet verworpen en kan de regen wel met een homogeen Poissonproces worden beschreven (de groene stukken in figuur 6.2b).
Er zijn dus meerdere deelperiodes met verschillende constante intensiteit achter elkaar

55

waarin de regen met een homogeen Poissonproces kan worden beschreven. Nemen we de regen van deze deelperiodes samen dan kunnen we deze regen beschrijven met een inhomogeen Poissonproces met stuksgewijs constante intensiteit. Een inhomogeen Poissonproces met stuksgewijs constante intensiteit lijkt dus een redelijk model om regenbuien in Afrika mee te modelleren.

Discussie
Bij het onderzoeken of de regen met een homogeen Poissonproces kan worden beschreven, zijn resultaten uit eerder onderzoek van de Villiers e.a., 2021 bevestigd. Alle regen van de gehele observatieperiode kan niet goed met een homogeen Poissonproces worden beschreven maar er zijn wel deelperiodes, vooral met een lage intensiteit, waarin de regen wel met een homogeen Poissonproces kan worden beschreven.
De data hebben we echter op het oog ingedeeld in deelperiodes waardoor we vanwege p-hacking of data snooping voorzichtig moeten zijn met het trekken van conclusies. Door vervolgens gebruik te maken van taut string hebben we de regendata op een objectievere manier ingedeeld in deelperiodes. Deze methode is objectiever maar er is nog steeds een gedeelte dat ‘op het oog’ gebeurt. Er moet namelijk een penalty parameter gekozen worden. Door eerst voor honderd gegenereerde datasets de optimale penalty parameter te bepalen en daarna het gemiddelde van die optimale penalty parameters te gebruiken om de intensiteit van de data te schatten zijn we wel een laag dieper te werkt gegaan dan wanneer we zomaar een penalty parameter hadden gekozen en die hadden gebruikt om de intensiteit van de data te schatten.

Door gebruik te maken van taut string zijn er twee zaken waar we rekening mee moeten houden.
De eerste is dat de observatieperiode wordt ingedeeld in deelperiodes met constante intensiteit. De gemiddelde lengte van deze deelperiodes is 36 intervallen van 10 seconden, maar van de 474 deelperiodes zijn er ook 297 die bestaan uit tien intervallen of minder. Deze deelperiodes bestaan dus uit een gering aantal observaties waardoor de nulhypothese niet snel verworpen zal worden. Het zou dus kunnen dat we voor sommige deelperiodes concluderen dat de regen met een homogeen Poissonproces kan worden beschreven terwijl dit eigenlijk niet zo is.
De tweede is dat we aannemen dat de intensiteit van een inhomogeen Poissonproces te benaderen is met een stuksgewijs constante functie. Het zou echter ook kunnen dat een andere functie, bijvoorbeeld een gladde functie, de intensiteit van een inhomogeen Poissonproces beter benadert.

Een laatste punt waar rekening mee gehouden moet worden, is dat in deze scriptie data gebruikt is, die is verzameld gedurende twee dagen op één locatie op Mafia eiland. Het feit dat een inhomogeen Poissonproces met stuksgewijs constante intensiteit voor deze regen een redelijk model lijkt te zijn, hoeft niet te betekenen dat dit voor de rest van het jaar en voor de andere landen in Afrika ook het geval is.

Aanbevelingen
Voor vervolg onderzoek zou het interessant kunnen zijn om meerdere intervalometers op dezelfde locatie te plaatsen. Zo kan je van dezelfde regenbui gegevens verzamelen met meerdere intervalometers. De gegevens van één intervalometer zou je kunnen gebruiken om de intensiteit van de regen te schatten en de gegevens van de andere intervalometer(s) zou je kunnen gebruiken om de intensiteit te verifiëren in plaats van dat je de intensiteit verifieert via gesimuleerde data.

56 | 6. Conclusie en Discussie

Wat ook nog interessant kan zijn, is om te onderzoeken of er voor een deelperiode een minimum aantal observaties is zodat we kunnen voorkomen dat we onterecht de nulhypothese niet verwerpen.
Voor een deelperiode met weinig observaties zal je niet snel verwerpen dat de regen te beschrijven is met een homogeen Poissonproces. Ook niet als de regen niet te beschrijven is met een homogeen Poissonproces. We verwerpen de nulhypothese dus onterecht niet. Als we zouden weten vanaf hoeveel observaties per deelperiode dit onterecht niet verwerpen van de nulhypothese weinig meer voorkomt, dan kunnen we daar rekening mee houden. We kunnen bijvoorbeeld bij taut string de penalty parameter zo kiezen dat bijna alle deelperiodes meer observaties bevatten dan het minimum aantal. Zo beperken we het aantal deelperiodes waarvoor we de regen classificeren als Poisson terwijl die niet Poisson is, en zo kunnen we betere conclusies trekken of het Poissonproces, homogeen of inhomogeen, en redelijk model is om regenbuien in Afrika mee te modelleren.

# Bibliografie

Bijma, F., Jonker, M. & van der Vaart, A. (2017). Method of Moments Estimators. In F. Bijma,
M. Jonker & A. van der Vaart (Red.), An Intoruction to Mathematical Statistics (pp. 72– 74). Amsterdam University Press.
Cumulants. (2013). Verkregen 23 juni 2022, van http : / / www . stat . uchicago . edu / ~pmcc / courses/stat306/2013/cumulants.pdf (http://www.stat.uchicago.edu/~pmcc/courses/stat306/2013/cumulants.pdf)
DelftGlobal. (2022). TU Delft Global Initiative. Verkregen 23 juni 2022, van https://www.tudelft.nl/global (https://www.tudelft.nl/global)
de Villiers, D. (2019). Something fishy going on! Evaluating the Poisson hypothesis for rainfall estimation using intervalometers: first results from an experiment in Tanzania.
de Villiers, D., Schleiss, M., ten Veldhuis, M.-C., Hut, R. & van de Giesen, N. (2021). Something fishy going on? Evaluating the Poisson hypothesis for rainfall estimation using intervalometers: results from an experiment in Tanzania. Atmospheric Measurement Techniques, 14(8), 5607–5623. https://doi.org/https://doi.org/10.5194/amt-14-5607-2021 (https://doi.org/https://doi.org/10.5194/amt-14-5607-2021)
Dümbgen, L. & Kovac, A. (2009). Extensions of smoothing via taut strings. Electronic Journal of Statistics, 3(none), 41–75. https://doi.org/https://doi.org/10.1214/08-EJS216 Grimmett, G. & Welsh, D. (2014). Probability: An Introduction (Second). Oxford University Press.
Gürtler, N. & Henze, N. (2000). Recent and classical goodness-of-fit tests for the Poisson distribution. Journal of Statistical Planning and Inference, 90(2), 207–225. https://doi.org/https://doi.org/10.1016/S0378-3758(00)00114-2 (https://doi.org/https://doi.org/10.1016/S0378-3758(00)00114-2)
Henze, N. (1996). Empirical-distribution-function goodness-of-fit tests for discrete models. The Canadian Journal of Statistics / La Revue Canadienne de Statistique, 24(1), 81–93. https://doi.org/https://doi.org/10.2307/3315691
Hoagline, D. C. (1980). A poissonness plot. The American Statistician, 34, 146–149. Karlis, D. & Xekalaki, E. (2000). A Simulation Comparison of Several Procedures for Testing the Poisson Assumption. Journal of the Royal Statistical Society: Series D (The Statistician), 49(3), 355–382. https://doi.org/https://doi.org/10.1111/1467-9884.00240 Kim, A. (2019). Sum of Exponential Random Variables. Verkregen 30 juni 2022, van https: //www.researchgate.net/publication/1844713_Inter-arrival_time_distribution_for_the_ non-homogeneous_Poisson_process (https://www.researchgate.net/publication/1844713_Inter-arrival_time_distribution_for_the_non-homogeneous_Poisson_process)
Klar, B. (1999). Goodness-of-fit tests for discrete models based on the integrated distribution function. Metrika, 49, 53–69. https://doi.org/https://doi.org/10.1007/s001840050025 KNMI. (2022). Automatische Weerstations. Verkregen 20 juni 2022, van https://www.knmi.nl/kennis-en-datacentrum/uitleg/automatische-weerstations (https://www.knmi.nl/kennis-en-datacentrum/uitleg/automatische-weerstations)
Lechner, I., Evans, N., Markakis, V. & Vidak, M. (2021). P-value hacking. The Embassy of good science. Verkregen 16 mei 2022, van https://embassy.science/wiki/Theme:6b584d4e-2c9d-4e27-b370-5fbdb983ab46 (https://embassy.science/wiki/Theme:6b584d4e-2c9d-4e27-b370-5fbdb983ab46)
Lindsay, B. G. (1986). Exponential Family Mixture Models (with Least-Squares Estimators). The Annals of Statistics, 14(1), 124–137. http://www.jstor.org/stable/2241270 Lindsay, B. G. & Roeder, K. (1992). Residual Diagnostics for Mixture Models. Journal of the American Statistical Association, 87(419), 785–794. https://doi.org/https://doi.org/10.2307/2290216 (https://doi.org/https://doi.org/10.2307/2290216)

57

58 | Bibliografie

Nieuwenhuizen, M. (2010). Luisteren naar regendruppels. Verkregen 18 juni 2022, van https: //www.nemokennislink.nl/publicaties/luisteren-naar-regendruppels/
ONSET. (2022). HOBO Rain Gauge Data Logger. Verkregen 18 juni 2022, van https://www.onsetcomp.com/products/data-loggers/rg3/
Ord, J. K. (1967). Graphical methods for a class of discrete distributions. Journal of the Royal Statistical Society: Series A, 130, 232–238.
Our Mandate. (2022). Verkregen 20 juni 2022, van https://www.tudelft.nl/citg/over-faculteit/
| afdelingen / watermanagement / medewerker / staff - water - resources - management /
headsecretary/prof-dr-ir-nick-van-de-giesen (https://www.tudelft.nl/citg/over-faculteit/afdelingen/watermanagement/medewerker/staff-water-resources-management/headsecretary/prof-dr-ir-nick-van-de-giesen)
Pennsylvania State University, S. (2018). Bootstrapping. PennState Eberly College of Science. Verkregen 3 mei 2022, van https://online.stat.psu.edu/stat555/node/119/
Pishro-Nik, H. (2014). Poisson processes [toegankelijk via https://www.probabilitycourse.com/].
| In H. Pishro-Nik (Red.), Introduction to probability, statistics and random processes.
Kappa Research LLC.
Santner, T. & Duffy, D. (1989). The Statistical Analysis of Discrete Data. Springer.
Spinelli, J. J. & Stephens, M. A. (1997). Cramér-von Mises Tests of Fit fot het Poisson Dis-
| tribution. The Canadian Journal of Statistics / La Revue Canadienne de Statistique,
25(2), 257–268. https://doi.org/https://doi.org/10.2307/3315735
TUDelft. (2010). Trans-African Hydro-Meteorological Observatory [Video]. Youtube. Verkregen 6 april 2022, van https://youtu.be/Nh7GDD3Ssr8
TUDelft. (2019). 20.000 weerstations in Afrika. Verkregen 20 juni 2022, van https:// www . tudelft.nl/citg/onderzoek/stories-of-science/20000-weerstations-in-afrika
TUDelft. (2022a). INtervalometer. Verkregen 7 april 2022, van https://www.tudelft. nl/ citg/
| over - faculteit / afdelingen / watermanagement / medewerker / staff - water - resources -
management/headsecretary/prof-dr-ir-nick-van-de-giesen (https://www.tudelft.nl/citg/over-faculteit/afdelingen/watermanagement/medewerker/staff-water-resources-management/headsecretary/prof-dr-ir-nick-van-de-giesen)
TUDelft. (2022b). Trans African Hydro Meteorological Observatory (TAHMO). Verkregen 7
| april 2022, van https://www.tudelft.nl/citg/over-faculteit/afdelingen/watermanagement/ onderzoek/chairs/water-resources/water-resources-management/research/projects/

trans-african-hydro-meteorological-observatory-tahmo (https://www.tudelft.nl/citg/over-faculteit/afdelingen/watermanagement/onderzoek/chairs/water-resources/water-resources-management/research/projects/trans-afri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)
van de Giesen, N. (2019). Intervalometer. Verkregen 18 juni 2022, van https://github.com/nvandegiesen/Intervalometer/wiki/Intervalometer (https://github.com/nvandegiesen/Intervalometer/wiki/Intervalometer)
Winton, C. (2009). Lecture notes in Computer Assisted Diagnosis.
Yakovlev, G., Rundle, J., Shcherbakov, R. & Turcotte, D. (2005). Inter-arrival time distribution
| for the non-homogeneous Poisson process. https://www.researchgate.net/publication/ 1844713 _ Inter - arrival _ time _ distribution _ for _ the _ non - homogeneous _ Poisson _

process (https://www.researchgate.net/publication/1844713_Inter-arrival_time_distribution_for_the_non-homogeneous_Poisson_process)
