nvandegiesen/Intervalometer/BasicCircuit.png

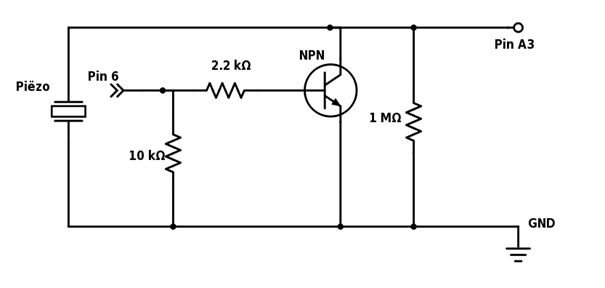
BasicCircuit.png
