nvandegiesen/Intervalometer/Piezo_Holder.stl

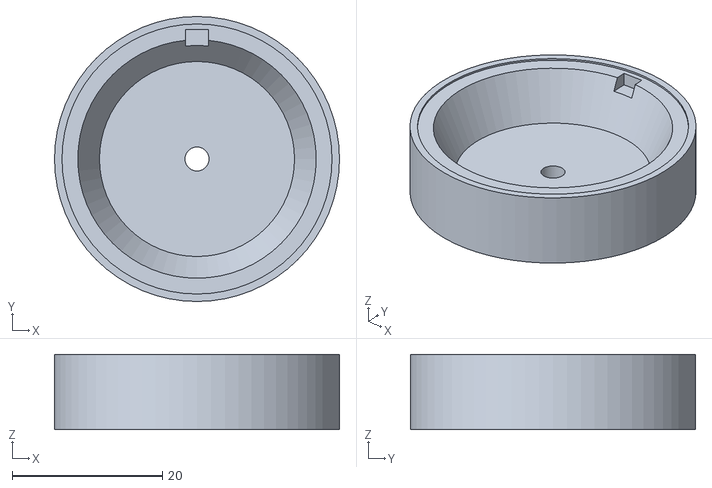
[picture p82: CAD file, 2017-04-04]
Piezo_Holder.stl
38.0 x 38.0 x 10.0
