nvandegiesen/Intervalometer/(commit log)

2017-04-04 Add files via upload
    Minor improvements in dimensions.
    [Piezo_Holder.scad, Piezo_Holder.stl]
2017-08-02 Add files via upload
    Arduino code for Drop Counter.
2018-06-19 Delete Sensor.jpg
    Replaced by zoom of original.
2018-06-19 Add files via upload
    Improved picture (zoom) of sensor.
2018-06-19 Add files via upload
    Better zoom of sensor.
2018-06-27 Add files via upload
    Removed RTC related bug.
    [Intervalometer2.ino]
